jaseg/sampling-mesh-monitor/analysis/jupyter_notebooks/edge_sampling_pulse_scope.pdf

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

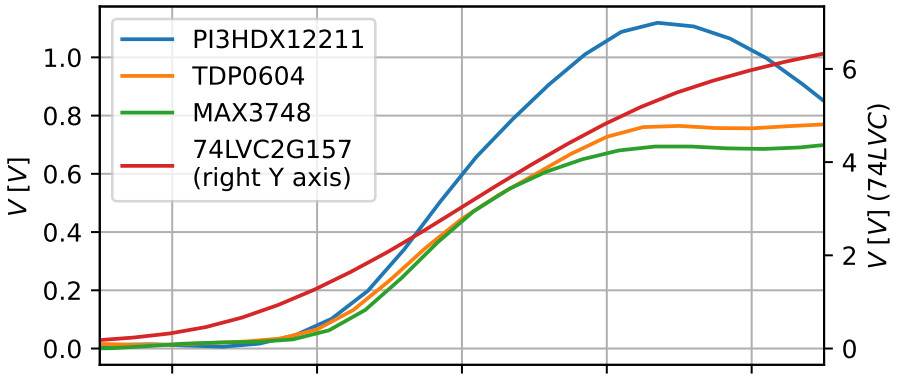
[picture p79: figure]
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
