jaseg/sampling-mesh-monitor/analysis/jupyter_notebooks/edge_stimulus_pulse_scope_normalized.pdf

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

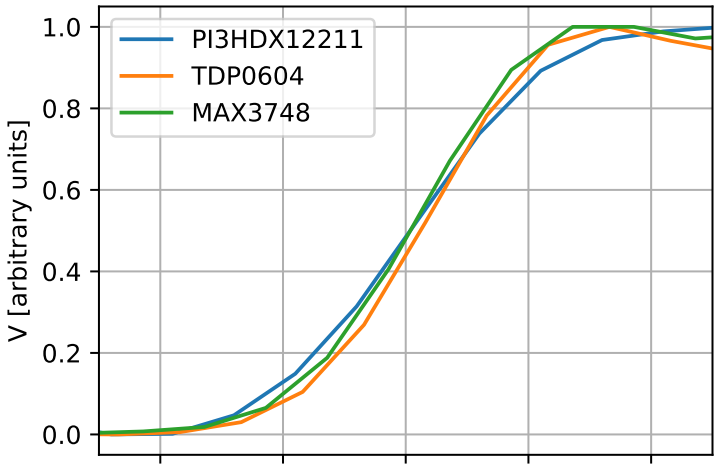
[picture p81: figure]
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
