jaseg/sampling-mesh-monitor/paper/fig_cdf_distinguish_copies_large_run.pdf

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

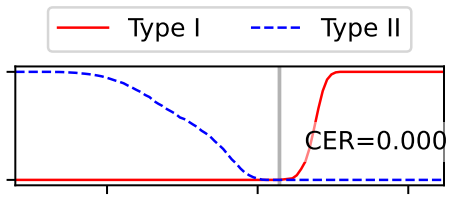
[picture p85: figure]
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
