jaseg/sampling-mesh-monitor/paper/fig_cdf_environment_p1.0_minmax.pdf

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

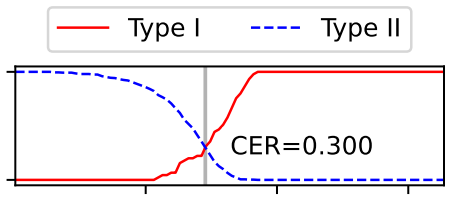
[picture p94: figure]
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
