jaseg/sampling-mesh-monitor/paper/fig_cdf_environment_ref_probe_p0.3_minmax.pdf

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

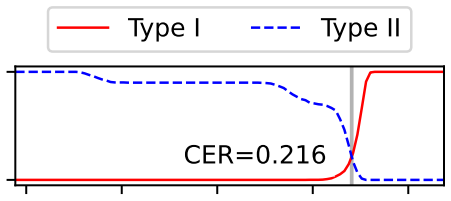
[picture p96: figure]
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
