jaseg/sampling-mesh-monitor/paper/fig_cdf_hot_mesh.pdf

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

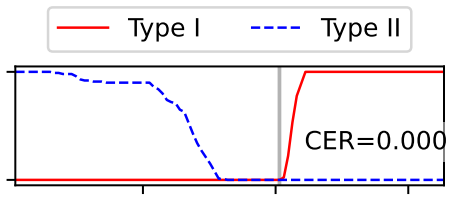
[picture p97: figure]
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
