jaseg/sampling-mesh-monitor/paper/fig_cdf_open_p0.4.pdf

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

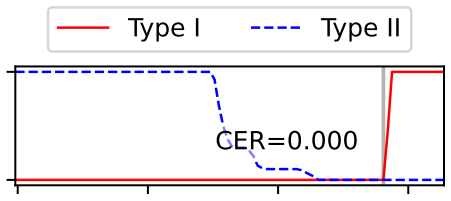
[picture p100: figure]
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
