jaseg/sampling-mesh-monitor/paper/fig_cdf_patch_0.3mm_large_sample_minmax.pdf

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

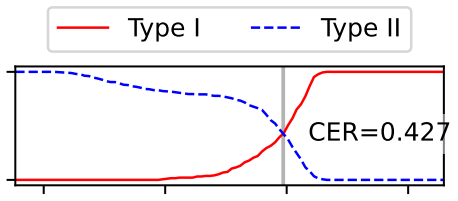
[picture p102: figure]
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
