jaseg/sampling-mesh-monitor/paper/fig_cdf_patch_interleave_classifier.pdf

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

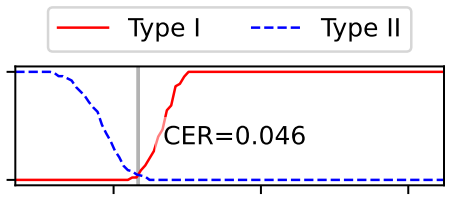
[picture p104: figure]
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
