jaseg/sampling-mesh-monitor/paper/fig_cdf_probe_0.4.pdf

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

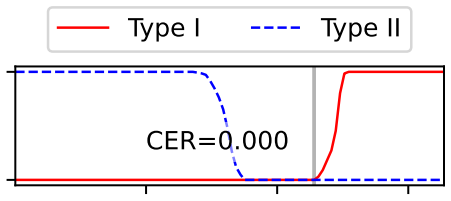
[picture p114: figure]
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
