jaseg/sampling-mesh-monitor/paper/fig_cdf_short_across_traces_p0.4.pdf

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

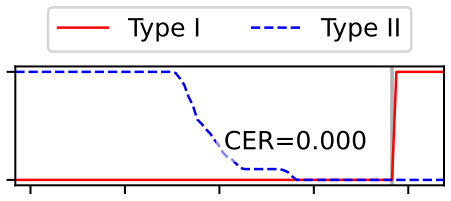
[picture p121: figure]
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
