jaseg/sampling-mesh-monitor/paper/fig_cdf_short_within_0.3_min_max.pdf

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

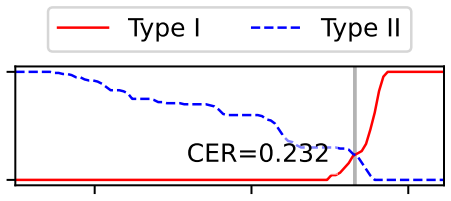
[picture p124: figure]
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
