jaseg/sampling-mesh-monitor/paper/fig_cdf_time_drift.pdf

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

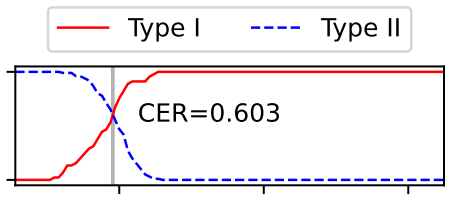
[picture p125: figure]
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
