jaseg/sampling-mesh-monitor/paper/fig_covar_antenna_wire_30mm_p0.3.pdf

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

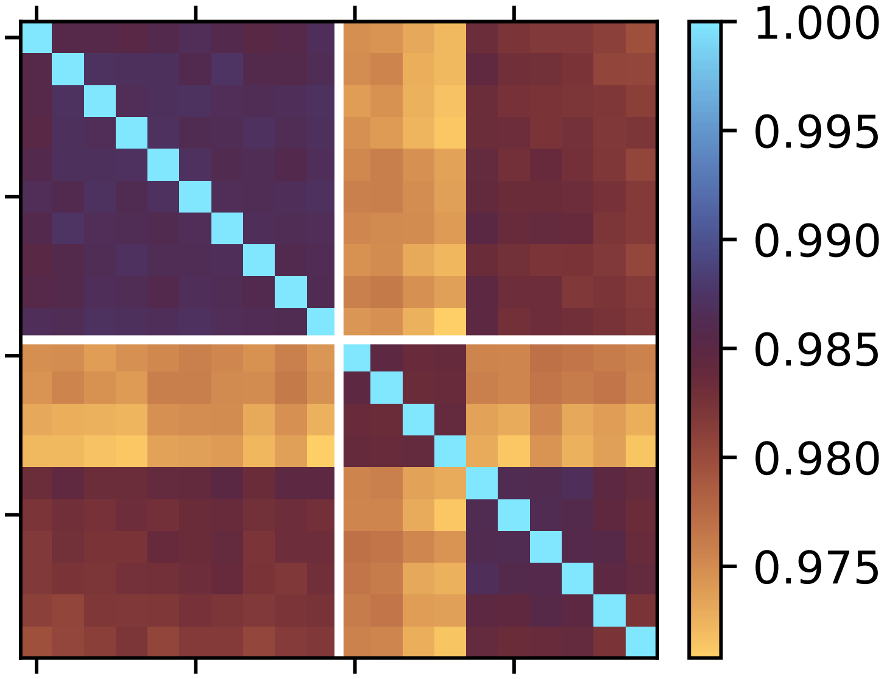
[picture p132: page 1]
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
