jaseg/sampling-mesh-monitor/paper/fig_covar_open_p0.4_minmax.pdf

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

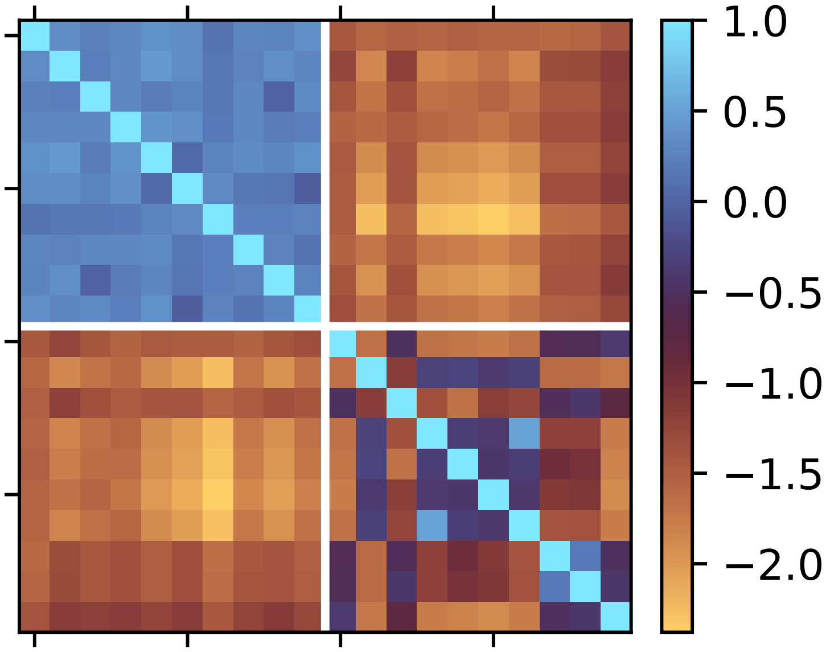
[picture p139: page 1]
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
