jaseg/sampling-mesh-monitor/analysis/data_multi/elevated_temperature_thermal_images/IRAY0331.jpg

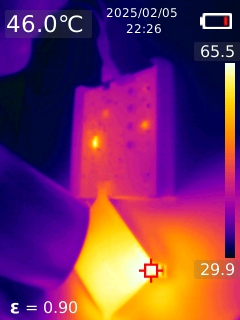
analysis/data_multi/elevated_temperature_thermal_images/IRAY0331.jpg
