jaseg/sampling-mesh-monitor/analysis/data_scope/max_osc.png

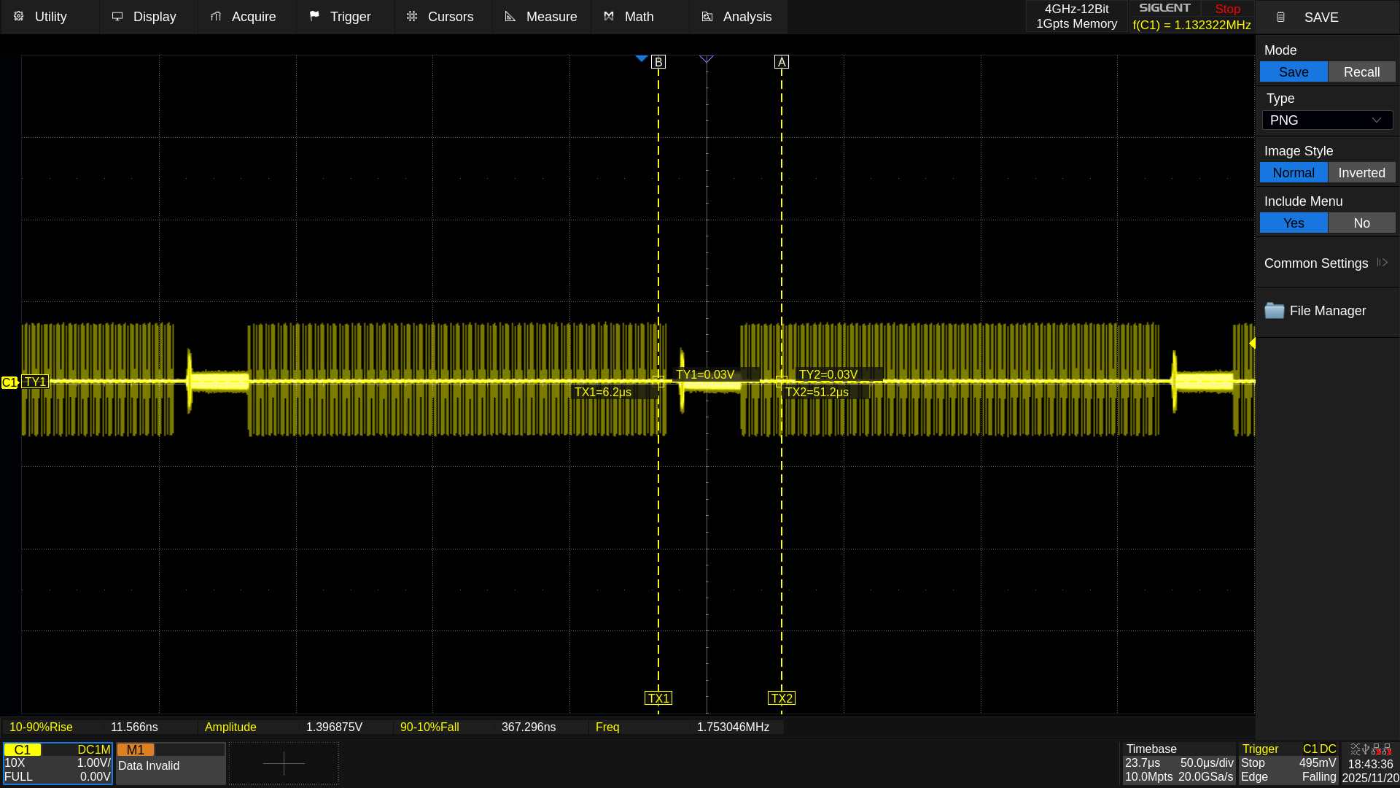
analysis/data_scope/max_osc.png
