jaseg/sampling-mesh-monitor/analysis/data_scope/max_pulse_neg_2.png

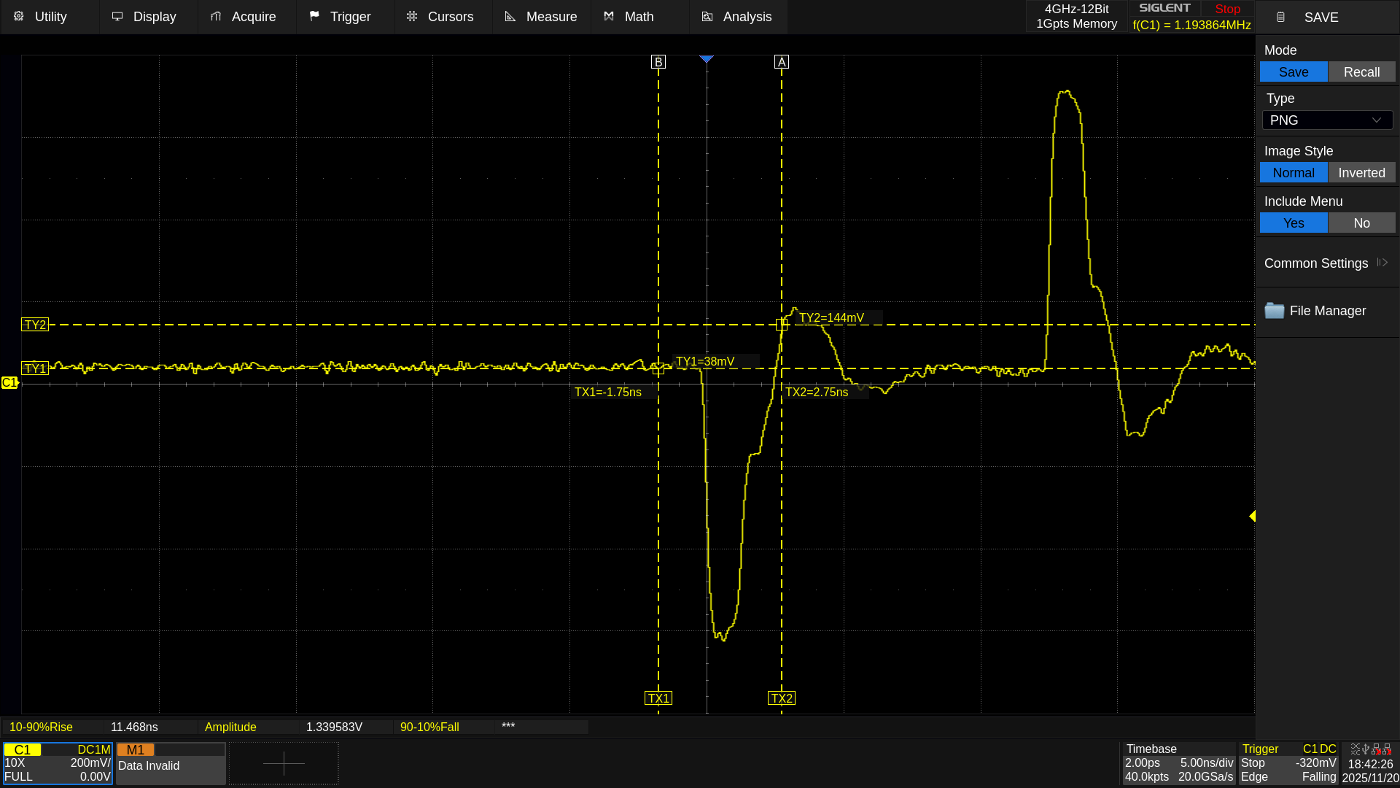
analysis/data_scope/max_pulse_neg_2.png
