jaseg/sampling-mesh-monitor/analysis/data_scope/pi3hdx_fall_74lvc_5.png

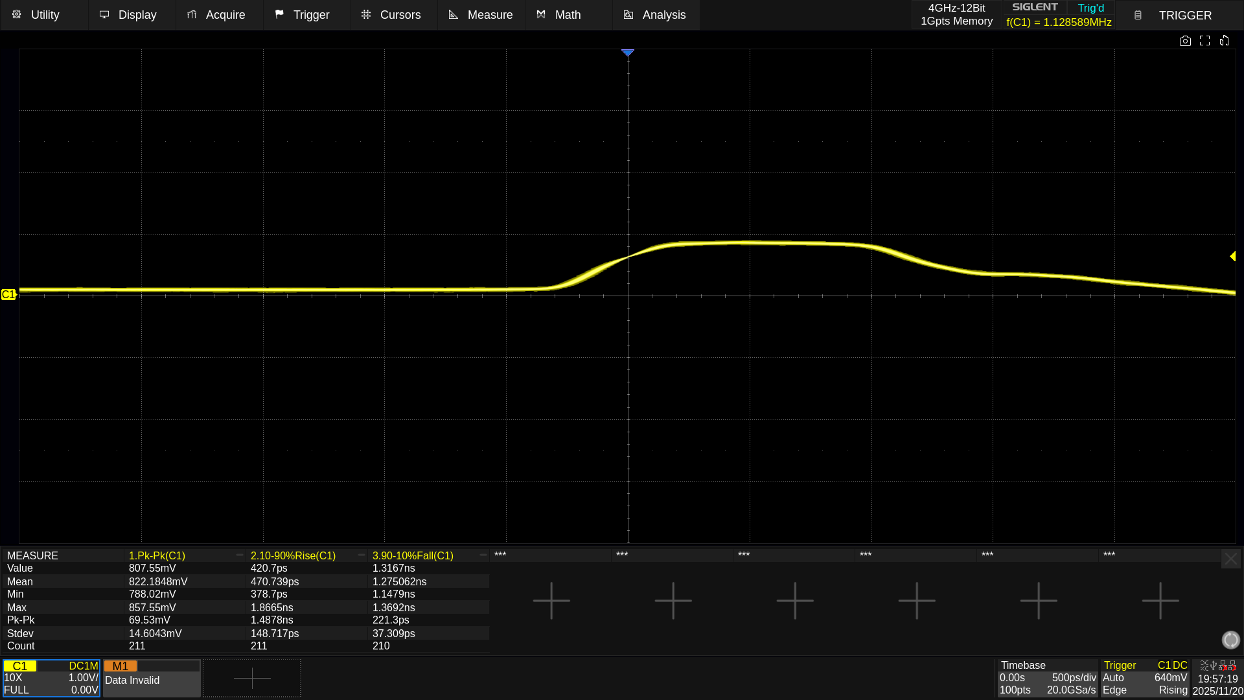
analysis/data_scope/pi3hdx_fall_74lvc_5.png
