jaseg/sampling-mesh-monitor/analysis/data_scope/stimulus_tdp0604_50ohm_13.png

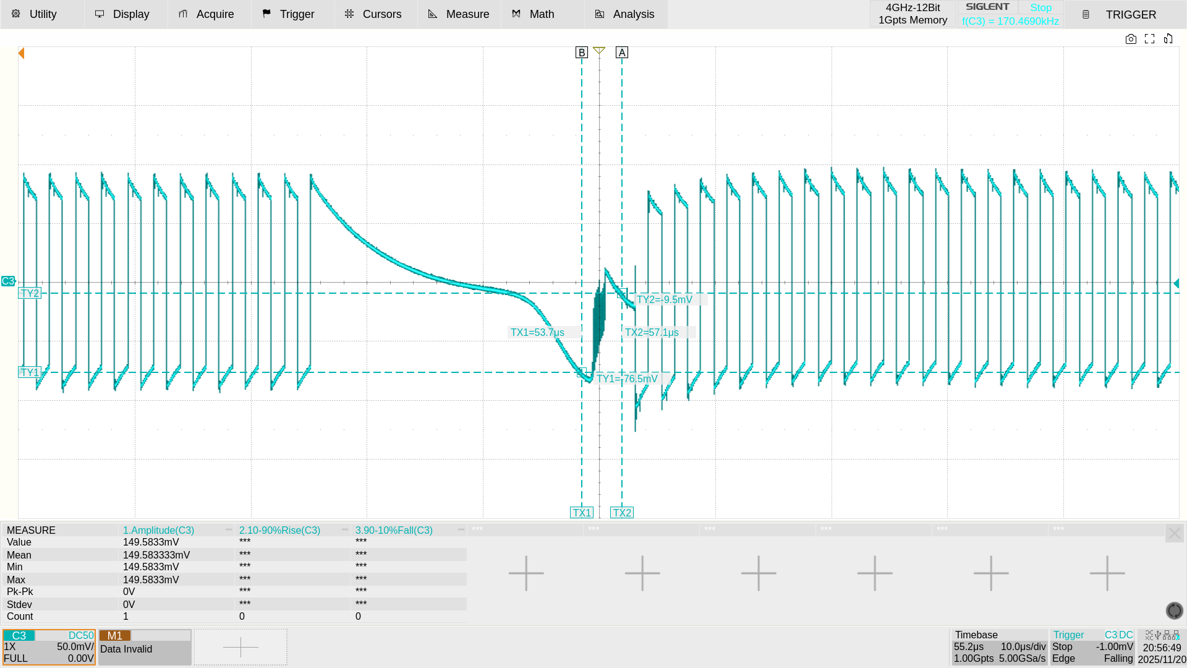
analysis/data_scope/stimulus_tdp0604_50ohm_13.png
