jaseg/sampling-mesh-monitor/analysis/data_scope/stimulus_tdp0604_50ohm_14.png

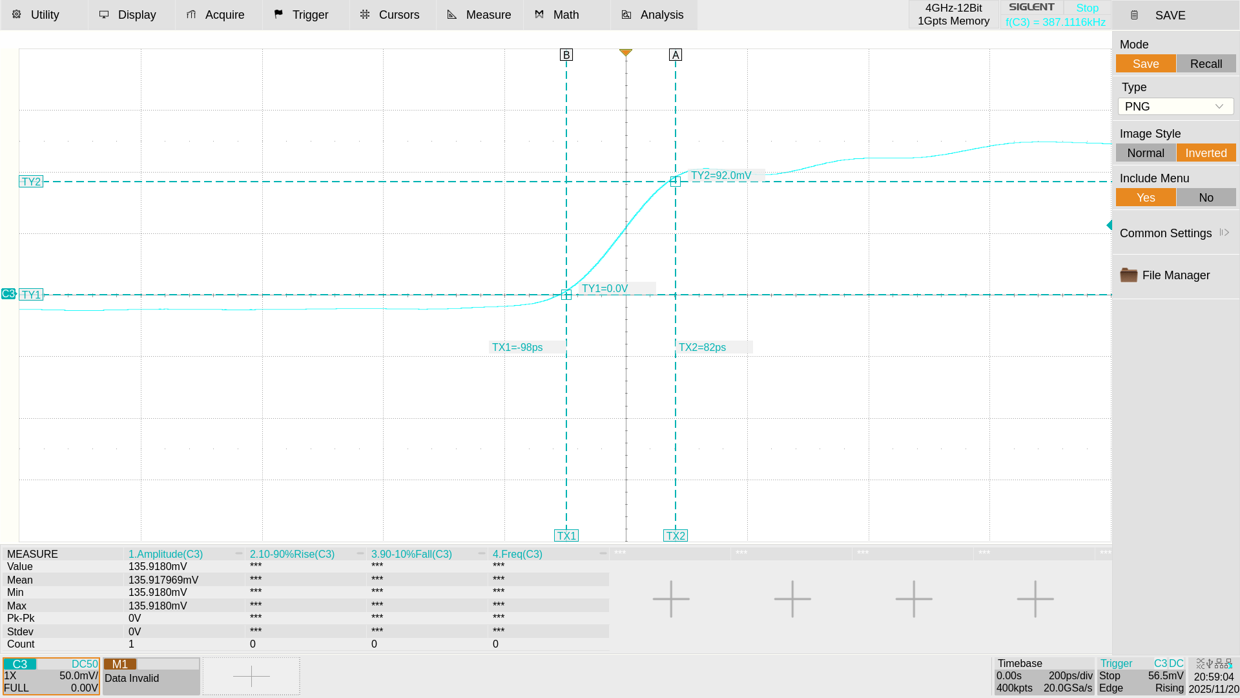
analysis/data_scope/stimulus_tdp0604_50ohm_14.png
