jaseg/sampling-mesh-monitor/analysis/jupyter_notebooks/edge_stimulus_pulse_scope_normalized.png

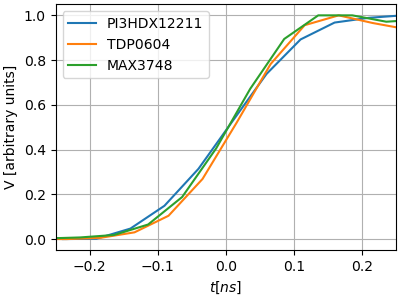
analysis/jupyter_notebooks/edge_stimulus_pulse_scope_normalized.png
