jaseg/sampling-mesh-monitor/paper/pic_cut_1.jpg

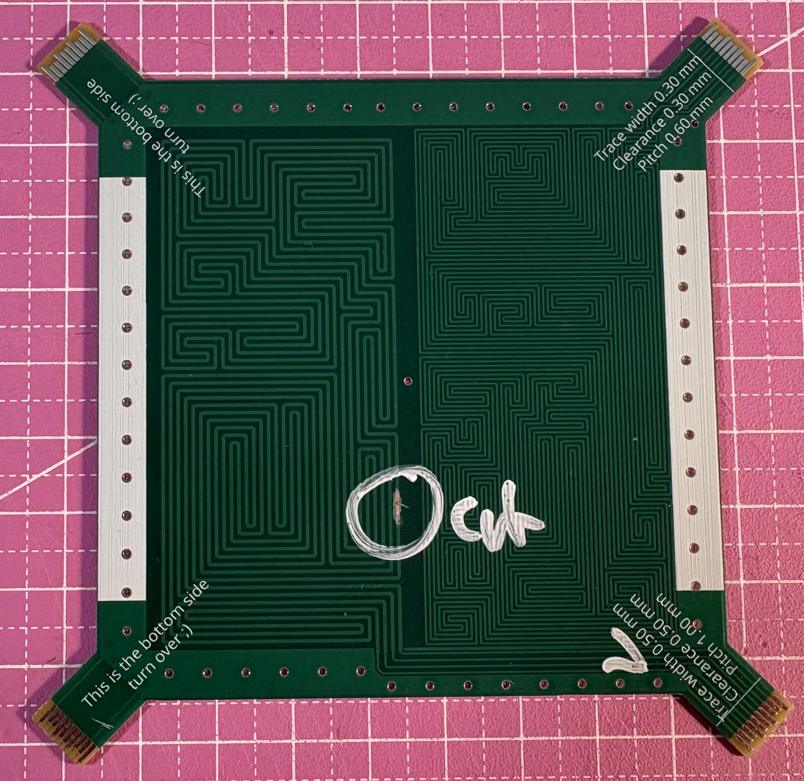
paper/pic_cut_1.jpg
