jaseg/sampling-mesh-monitor/paper/pic_short_1.jpg

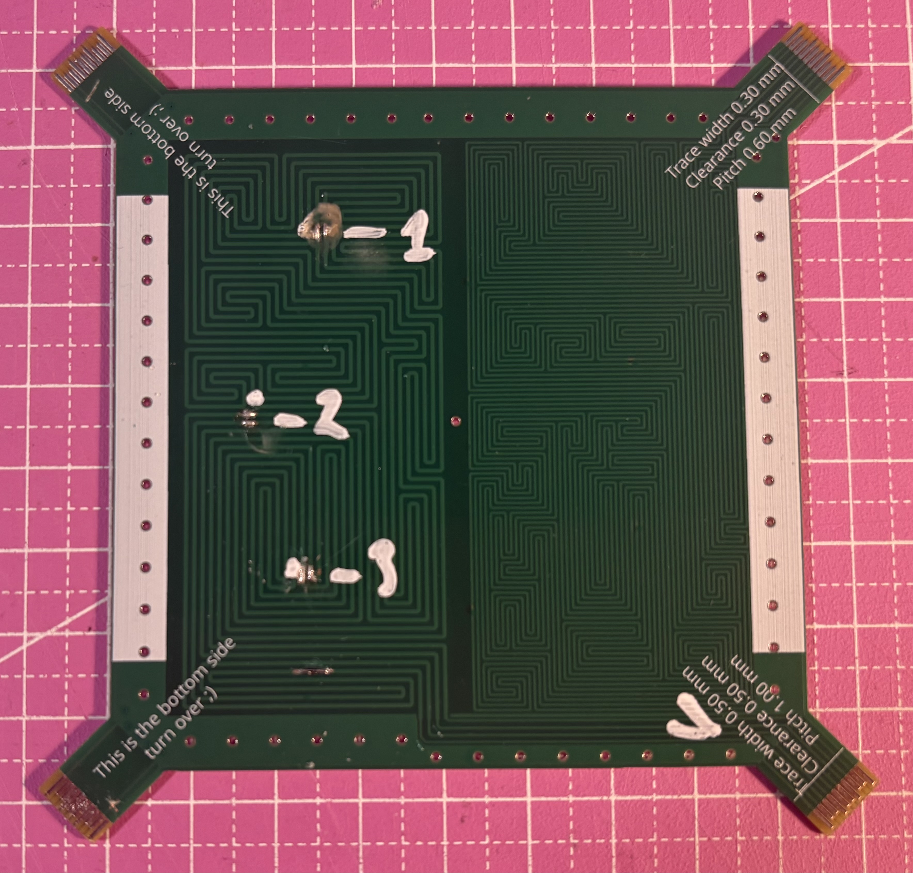
paper/pic_short_1.jpg
