jaseg/sampling-mesh-monitor/paper/pic_short_2.jpg

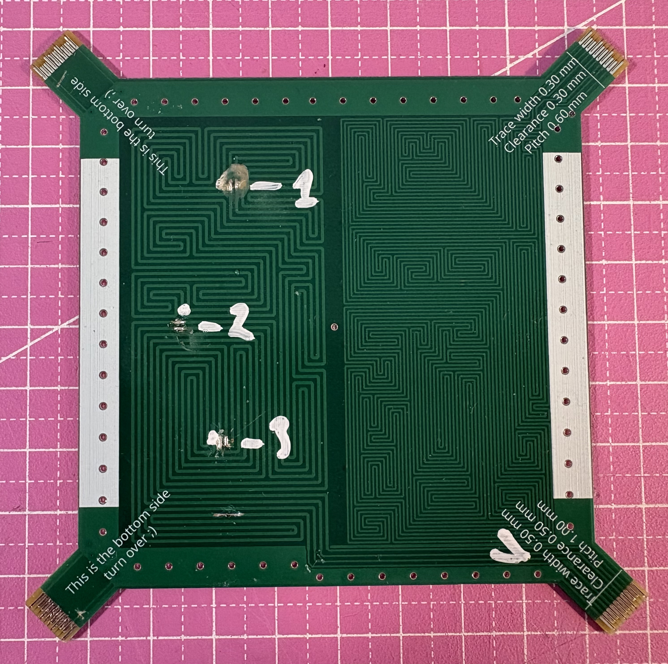
paper/pic_short_2.jpg
