jaseg/sampling-mesh-monitor/main_pcb/fab/bom.csv

Comment | Designator | Footprint | LCSC
22k | R68,R73,R75 | Resistor_SMD:R_0402_1005Metric | C25768
47u | C4,C70,C71,C72,C73 | Capacitor_SMD:C_Elec_6.3x7.7 | C88810
10n | C3,C11,C15,C17,C18,C19,C20,C21,C22,C23,C24,C25,C26,C31,C32,C33,C36,C41,C42,C43,C46,C49,C65,C67,C69,C74,C76,C90 | Capacitor_SMD:C_0402_1005Metric | C15195
1k | R4,R23,R24,R25,R26,R67,R80,R81,R82,R83,R85,R87 | Resistor_SMD:R_0402_1005Metric | C11702
45 | R18,R28,R58,R62 | Resistor_SMD:R_0402_1005Metric | C327342
3k3 | R27,R39,R65,R66 | Resistor_SMD:R_0402_1005Metric | C25890
1u | C2,C6,C7,C10,C12,C14,C27,C38,C39,C44,C48,C52,C56,C57,C58,C63,C75,C77,C78,C79,C80,C81,C84,C86,C88 | Capacitor_SMD:C_0805_2012Metric | C28323
0 | R9,R13,R14,R30,R31,R41,R44,R95,R96 | Resistor_SMD:R_0402_1005Metric | C17168
USBLC6-4SC6 | U10 | Package_TO_SOT_SMD:SOT-23-6 | C558419
AO3400A | Q1 | Package_TO_SOT_SMD:SOT-23 | C20917
10k | R40,R47,R48,R49,R70 | Resistor_SMD:R_0402_1005Metric | C2654005
100n | C1,C5,C8,C9,C13,C16,C28,C34,C35,C37,C40,C45,C47,C53,C54,C55,C59,C60,C62,C64,C66,C68,C82,C83,C85,C87,C89 | Capacitor_SMD:C_0402_1005Metric | C307331
75 | R8,R11,R12,R20,R32,R43 | Resistor_SMD:R_0402_1005Metric | C25133
BLM15HD102SN1D | FB1,FB2,FB3,FB4 | Inductor_SMD:L_0402_1005Metric | C21516
91 | R56,R57,R59,R61 | Resistor_SMD:R_0402_1005Metric | C4071412
1N4148W | D3,D5 | Diode_SMD:D_SOD-123 | C81598
47k | R71,R72,R77,R86 | Resistor_SMD:R_0402_1005Metric | C25792
PTN36241B | U4 | Package_DFN_QFN:QFN-24-1EP_4x4mm_P0.5mm_EP2.6x2.6mm | C2675242
0603 white | D1,D2,D4,D6,D7,D12,D13,D14,D15,D16,D17 | LED_SMD:LED_0603_1608Metric | C2290
SKYA21003 | U5,U6 | footprints:QFN-12_EP_2x2_Pitch0.5mm | C141440
74LVC2G157 | U2,U3 | Package_SO:MSOP-8_3x3mm_P0.65mm | C78048
30 | R42,R45,R51,R52,R53,R54 | Resistor_SMD:R_0402_1005Metric | C138007
100 | R84 | Resistor_SMD:R_0402_1005Metric | C25076
20p | C29,C30 | Capacitor_SMD:C_0402_1005Metric | C1554
OPA1656 | U11,U12,U13 | Package_SO:SO-8_3.9x4.9mm_P1.27mm | C1849431
BAT17-04W | D8,D9,D10,D11 | Package_TO_SOT_SMD:SOT-323_SC-70 | C503474
AMS1117-3.3 | U15,U16,U17 | Package_TO_SOT_SMD:SOT-223-3_TabPin2 | C6186
5k1 | R46,R63 | Resistor_SMD:R_0402_1005Metric | C25905
47 | R64,R78 | Resistor_SMD:R_0603_1608Metric | C23182
TMUXHS4212 | U7,U8 | Package_DFN_QFN:DHVQFN-20-1EP_2.5x4.5mm_P0.5mm_EP1x3mm | C3656912
1M | R74,R76,R79 | Resistor_SMD:R_0402_1005Metric | C138033
USB_C_Receptacle_USB2.0 | J2 | Connector_USB:USB_C_Receptacle_HCTL_HC-TYPE-C-16P-01A | C2988369
8MHz/20p | Y1 | Crystal:Crystal_SMD_5032-2Pin_5.0x3.2mm | C115962
SFP+ | J1 | footprints:HCTL_HC-SFP-20P_C2897291 | C2897291
100k | R69 | Resistor_SMD:R_0402_1005Metric | C25741
STM32G474RBTx | U9 | Package_QFP:LQFP-64_10x10mm_P0.5mm | C529413
TPS7B4253QPWPRQ1 | U1 | Package_SO:HTSSOP-20-1EP_4.4x6.5mm_P0.65mm_EP3.4x6.5mm_Mask2.4x3.7mm | C2879376
LP2998 | U14 | footprints:SOIC-8-1EP_3.9x4.9mm_P1.27mm_EP2.34x2.34mm | C181400
