jaseg/sampling-mesh-monitor/paper/fig_cdf_soldering_p0.3_minmax.pdf

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

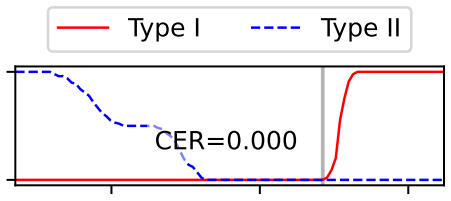
[picture p161: figure]
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
