jaseg/sampling-mesh-monitor/analysis/data_multi/forest_setup.jpg

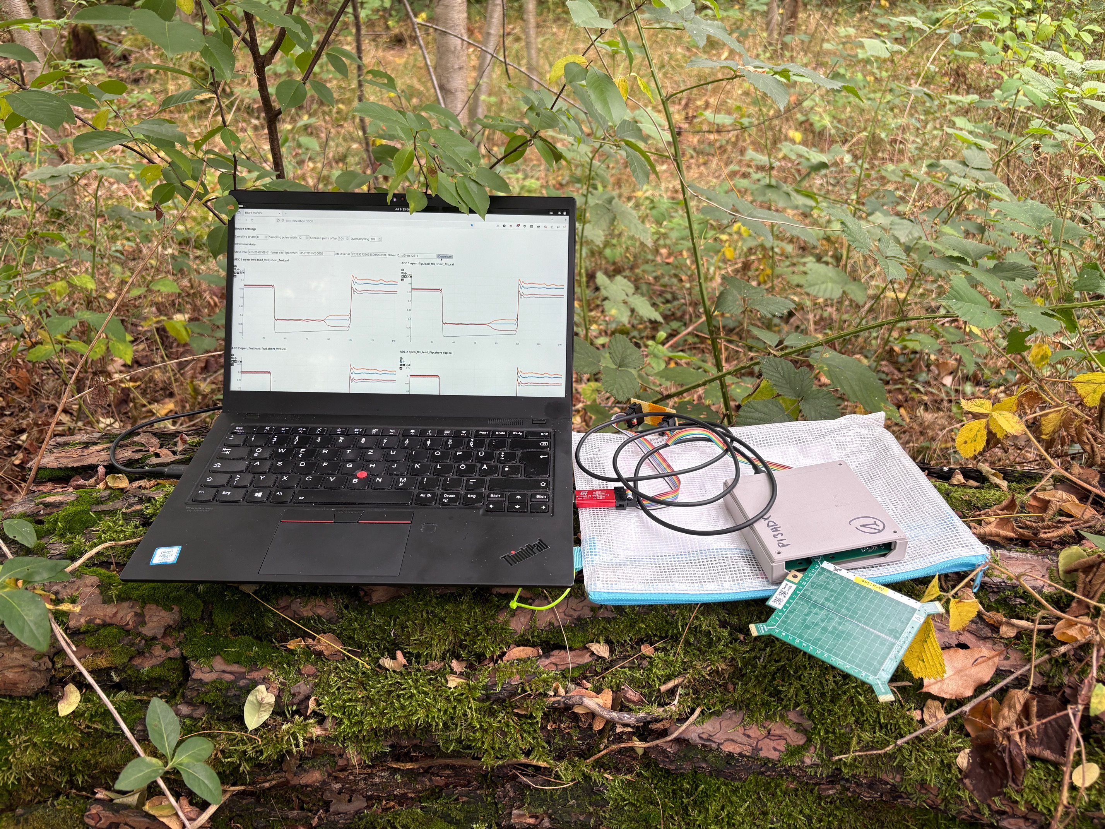
analysis/data_multi/forest_setup.jpg
