jaseg/sampling-mesh-monitor/paper/pic_board_setup.jpg

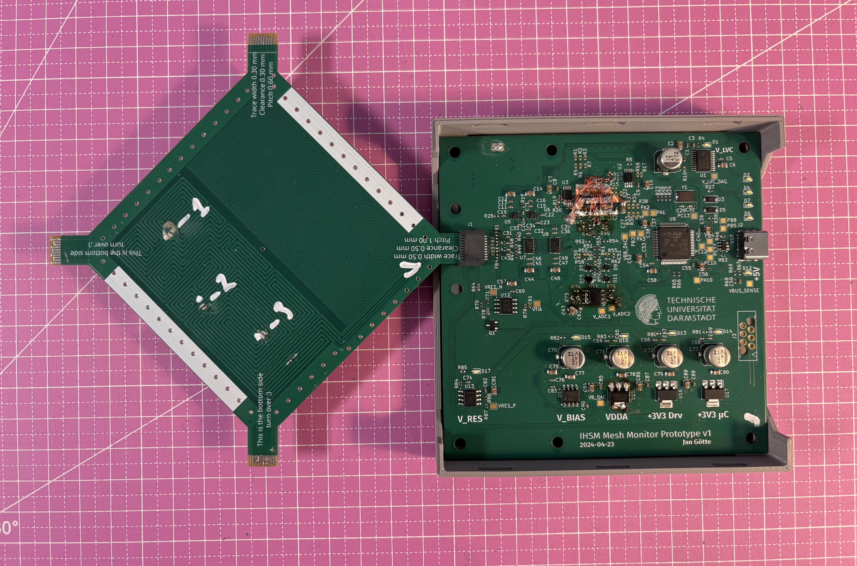
paper/pic_board_setup.jpg
