jaseg/sampling-mesh-monitor/paper/pic_board_setup_2_small_censored.jpg

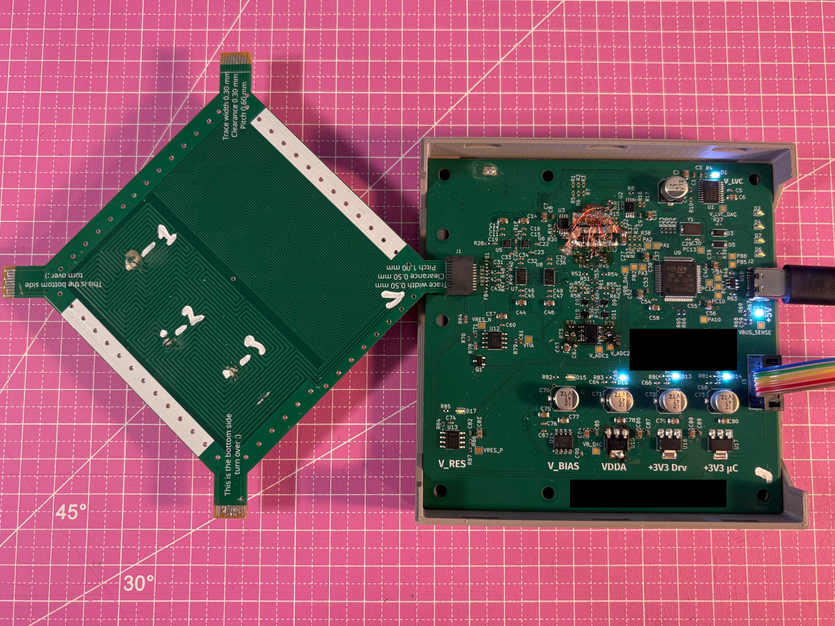
paper/pic_board_setup_2_small_censored.jpg
