jaseg/sampling-mesh-monitor/paper/pic_manip_microsoldering.jpg

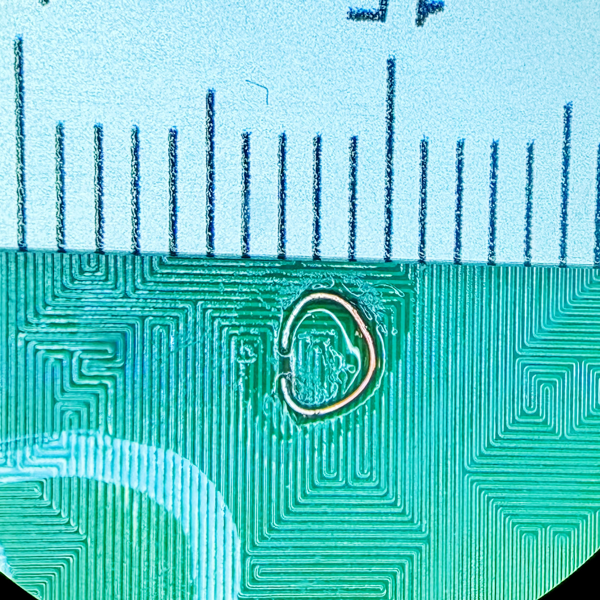
paper/pic_manip_microsoldering.jpg
