jaseg/sampling-mesh-monitor/paper/pic_manip_microsoldering_new.jpg

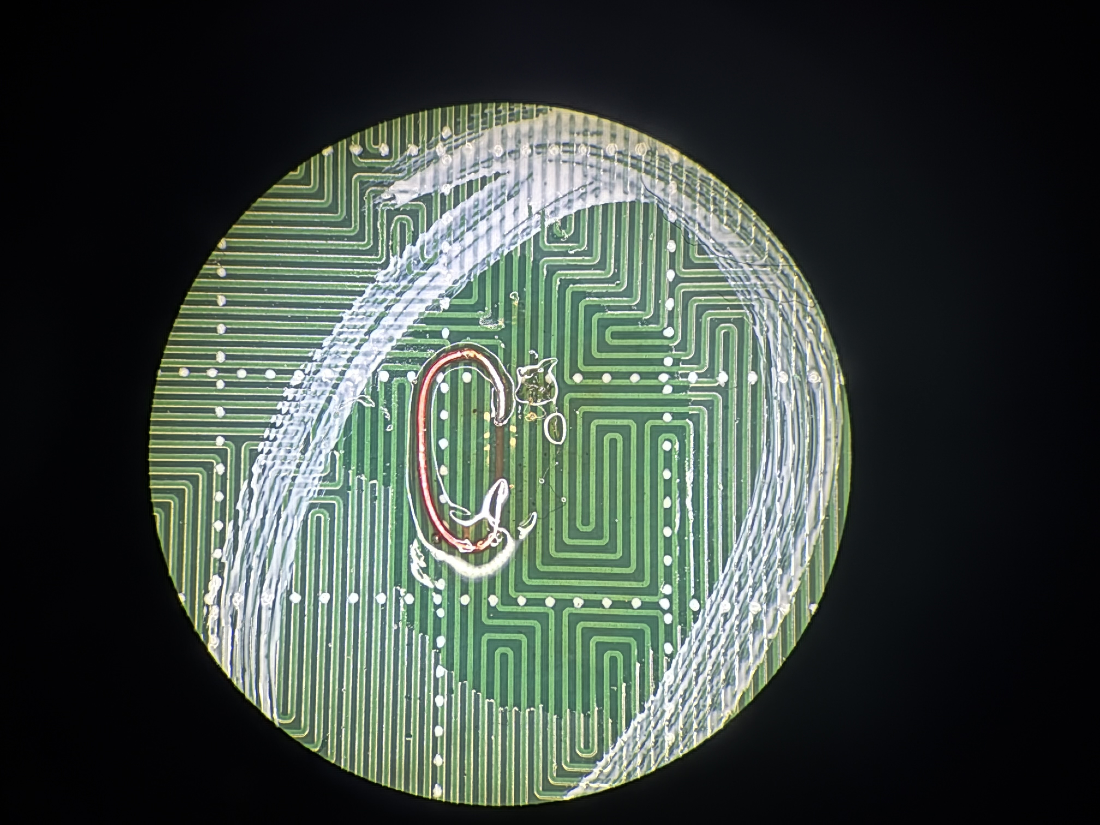
paper/pic_manip_microsoldering_new.jpg
