jaseg/sampling-mesh-monitor/analysis/spectrum_measurements/amp_out_span_2g.csv

Trace
Swept SA
A.14.16 | N9020A
526 | 01
Segment | 0
Number of Points | 1001
Sweep Time | 0.291066666667
Start Frequency | 1000000
Stop Frequency | 2000000000
Average Count | 0
Average Type | LogPower(Video)
RBW | 91000
RBW Filter | Gaussian
RBW Filter BW | 3dB
VBW | 91000
Sweep Type | Swept
X Axis Scale | Lin
PreAmp State | Off
PreAmp Band | Low
Trigger Source | Free
Trigger Level | 1.2
Trigger Slope | Positive
Trigger Delay | 0
Phase Noise Optimization | Fast
Swept If Gain | Low
FFT If Gain | Autorange
RF Coupling | AC
FFT Width | 411900
Ext Ref | 10000000
Input | RF
RF Calibrator | Off
Attenuation | 10
Ref Level Offset | 0
External Gain | 0
Trace Type | Clearwrite
Detector | Normal
Trace Math | Off
Trace Math Oper1 | Trace5
Trace Math Oper2 | Trace6
Trace Math Offset | 0
Normalize | Off
Trace Name | Trace1
X Axis Units | Hz
Y Axis Units | dBm
DATA
1000000 | -2.92567873001099
2999000 | -105.294227600098
4998000 | -81.9323806762695
6997000 | -106.628311157227
8996000 | -27.1905555725098
10995000 | -110.134819030762
12994000 | -83.3165969848633
14993000 | -106.727844238281
16992000 | -78.3774490356445
18991000 | -113.527038574219
20990000 | -86.3876037597656
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
