jaseg/sampling-mesh-monitor/analysis/spectrum_measurements/amp_out_span_2g_rbw_10k_40kpt_0000.csv

Trace
Swept SA
A.14.16 | N9020A
526 | 01
Segment | 0
Number of Points | 40001
Sweep Time | 24.104
Start Frequency | 1000000
Stop Frequency | 2000000000
Average Count | 0
Average Type | LogPower(Video)
RBW | 10000
RBW Filter | Gaussian
RBW Filter BW | 3dB
VBW | 10000
Sweep Type | Swept
X Axis Scale | Lin
PreAmp State | Off
PreAmp Band | Low
Trigger Source | Free
Trigger Level | 1.2
Trigger Slope | Positive
Trigger Delay | 0
Phase Noise Optimization | Fast
Swept If Gain | Low
FFT If Gain | Autorange
RF Coupling | AC
FFT Width | 411900
Ext Ref | 10000000
Input | RF
RF Calibrator | Off
Attenuation | 10
Ref Level Offset | 0
External Gain | 0
Trace Type | Clearwrite
Detector | Normal
Trace Math | Off
Trace Math Oper1 | Trace5
Trace Math Oper2 | Trace6
Trace Math Offset | 0
Normalize | Off
Trace Name | Trace1
X Axis Units | Hz
Y Axis Units | dBm
DATA
1000000 | -85.3238830566406
1049975 | -98.9215316772461
1099950 | -86.7866973876953
1149925 | -108.657447814941
1199900 | -88.6867828369141
1249875 | -114.095260620117
1299850 | -87.331413269043
1349825 | -106.659980773926
1399800 | -86.4431533813477
1449775 | -105.568656921387
1499750 | -87.967155456543
1549725 | -113.770057678223
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
