jaseg/sampling-mesh-monitor/analysis/spectrum_measurements/board_out_span_2g_rbw_10k_40kpt.csv

Trace
Swept SA
A.14.16 | N9020A
526 | 01
Segment | 0
Number of Points | 40001
Sweep Time | 24.104
Start Frequency | 1000000
Stop Frequency | 2000000000
Average Count | 0
Average Type | LogPower(Video)
RBW | 10000
RBW Filter | Gaussian
RBW Filter BW | 3dB
VBW | 10000
Sweep Type | Swept
X Axis Scale | Lin
PreAmp State | Off
PreAmp Band | Low
Trigger Source | Free
Trigger Level | 1.2
Trigger Slope | Positive
Trigger Delay | 0
Phase Noise Optimization | Fast
Swept If Gain | Low
FFT If Gain | Autorange
RF Coupling | AC
FFT Width | 411900
Ext Ref | 10000000
Input | RF
RF Calibrator | Off
Attenuation | 10
Ref Level Offset | 0
External Gain | 0
Trace Type | Clearwrite
Detector | Normal
Trace Math | Off
Trace Math Oper1 | Trace5
Trace Math Oper2 | Trace6
Trace Math Offset | 0
Normalize | Off
Trace Name | Trace1
X Axis Units | Hz
Y Axis Units | dBm
DATA
1000000 | -82.1544494628906
1049975 | -107.743324279785
1099950 | -84.4499359130859
1149925 | -106.985504150391
1199900 | -87.2609634399414
1249875 | -104.96794128418
1299850 | -88.4271774291992
1349825 | -105.71981048584
1399800 | -87.4483947753906
1449775 | -108.276962280273
1499750 | -90.7405319213867
1549725 | -104.996360778809
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
