jaseg/sampling-mesh-monitor/analysis/spectrum_measurements/amp_out_span_2g_rbw_10k_40kpt.png

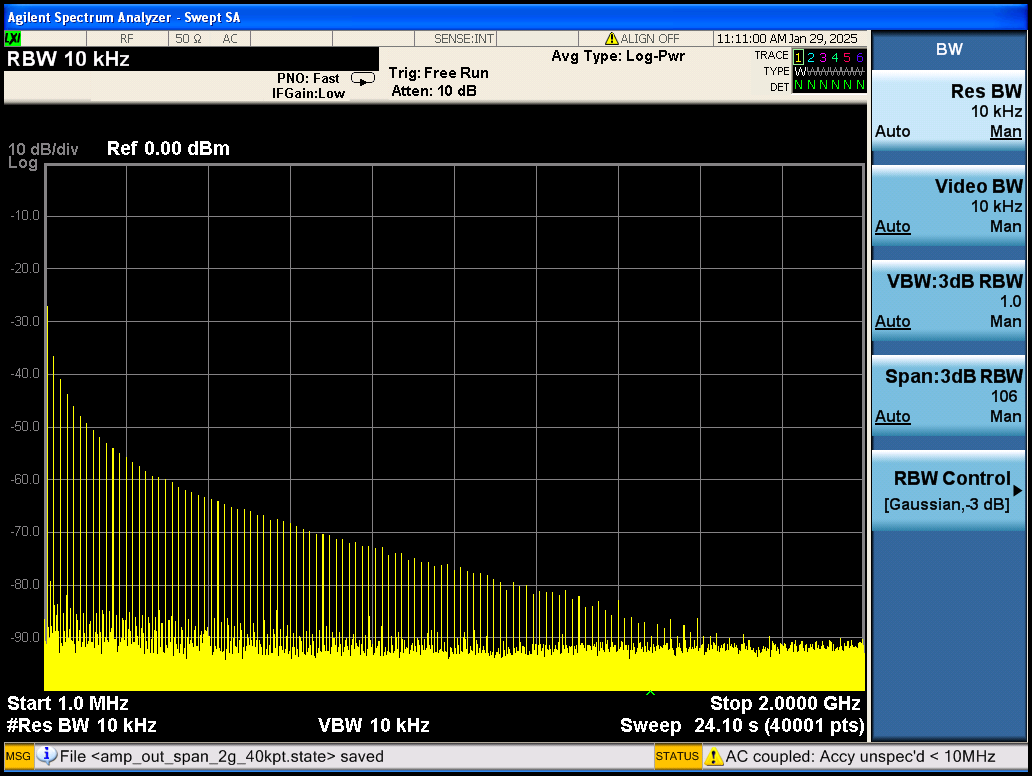
analysis/spectrum_measurements/amp_out_span_2g_rbw_10k_40kpt.png
