jaseg/sampling-mesh-monitor/main_pcb/schematics/sampling-mesh-monitor.pdf

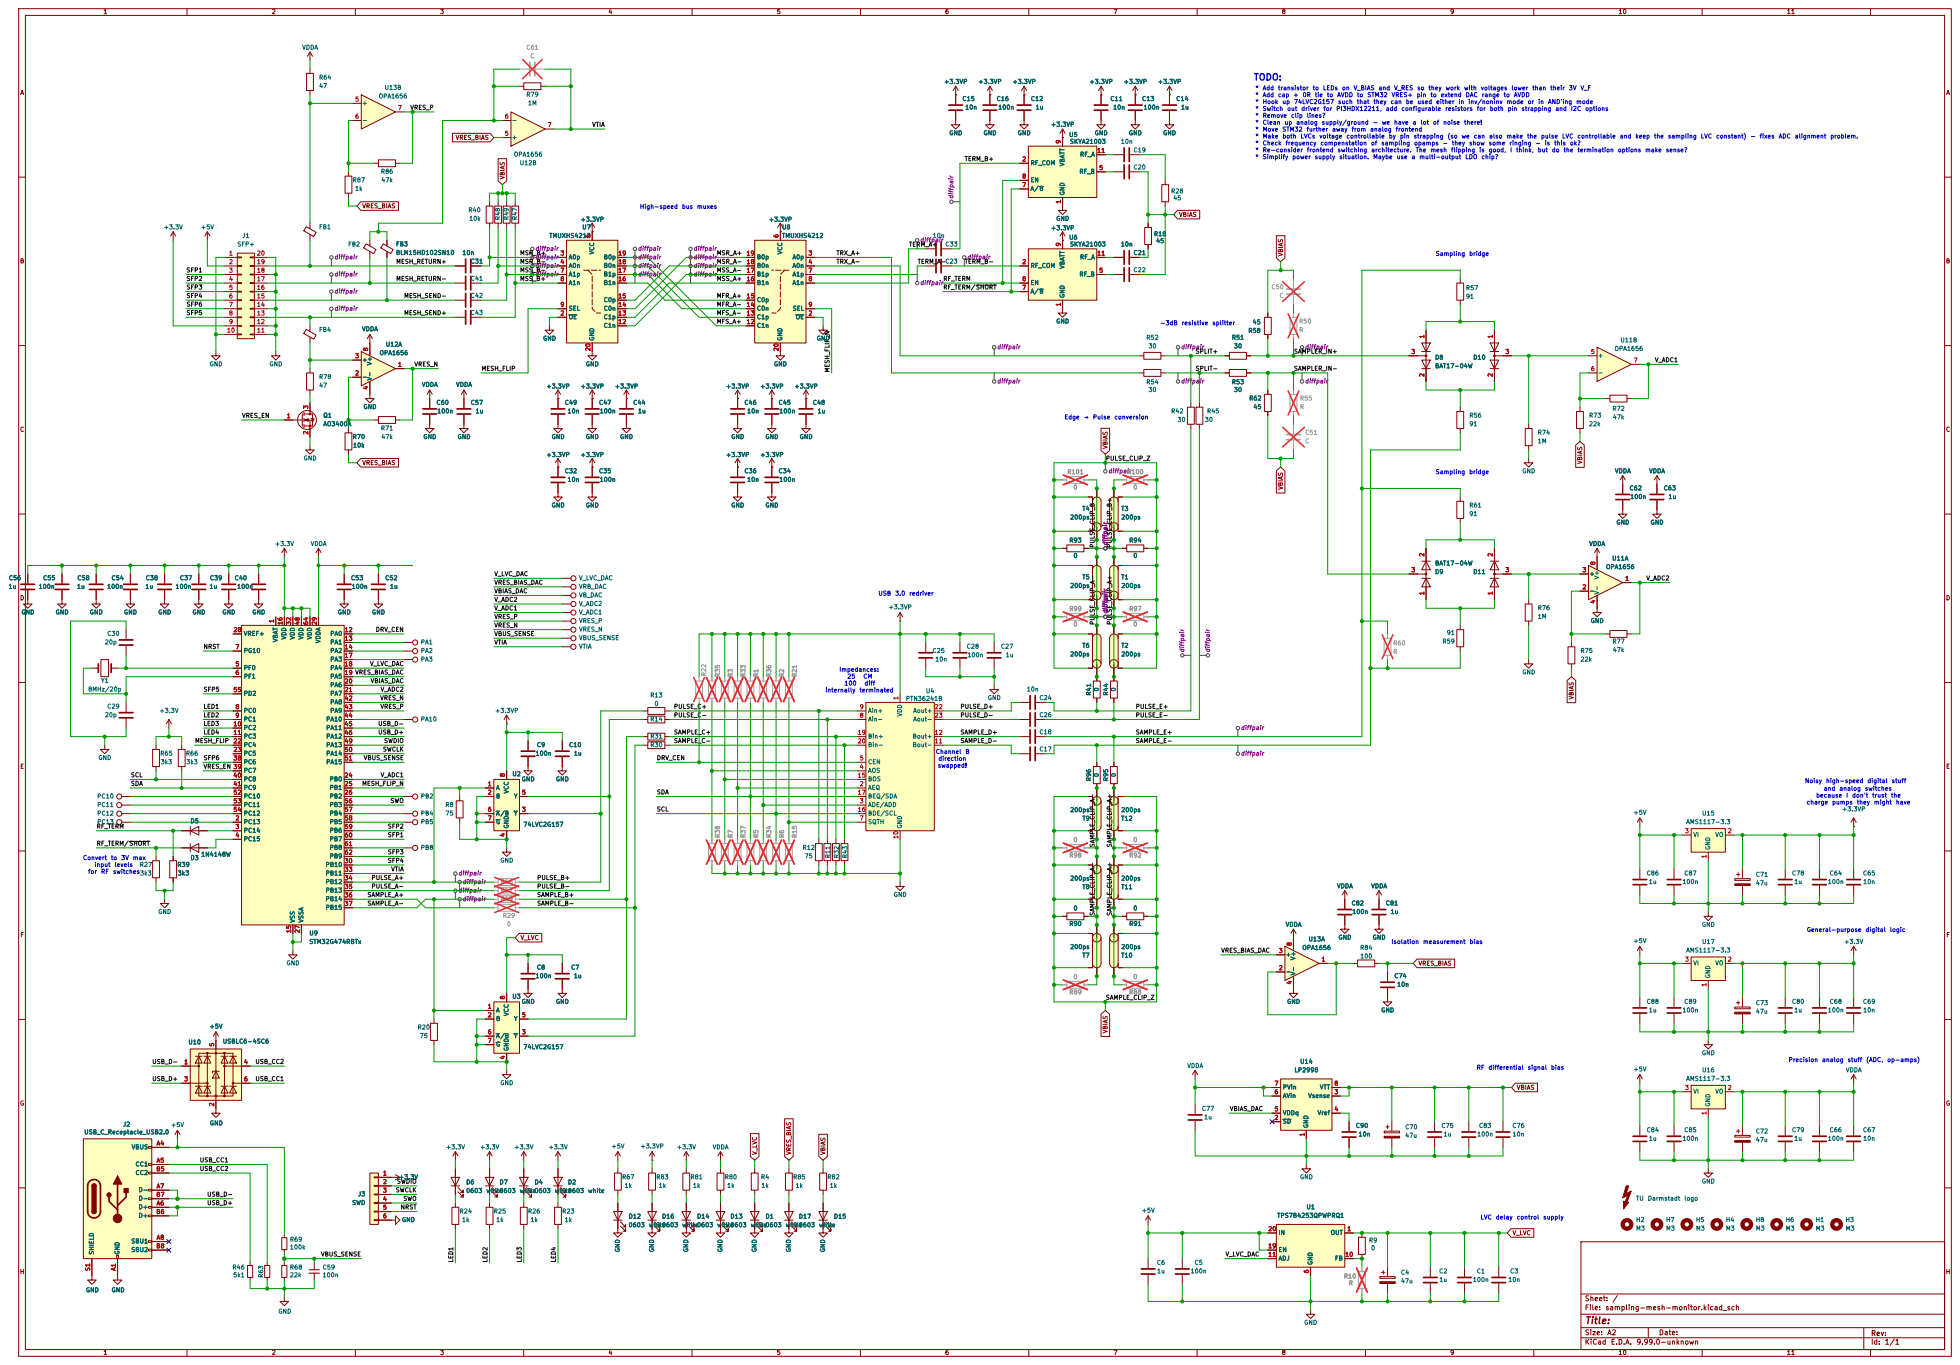
[picture p168: page 1]

* Add transistor to LEDs on V_BIAS and V_RES so they work with voltages lower than their 3V V_F
* Add cap + 0R tie to AVDD to STM32 VRES+ pin to extend DAC range to AVDD
* Hook up 74LVC2G157 such that they can be used either in inv/noninv mode or in AND'ing mode
* Switch out driver for PI3HDX12211, add configurable resistors for both pin strapping and I2C options
* Remove clip lines?
* Clean up analog supply/ground - we have a lot of noise there! * Move STM32 further away from analog frontend

* Make both LVCs voltage controllable by pin strapping (so we can also make the pulse LVC controllable and keep the sampling LVC constant) - fixes ADC alignment problem.
* Check frequency compenstation of sampling opamps - they show some ringing - is this ok?
* Re-consider frontend switching architecture. The mesh flipping is good, I think, but do the termination options make sense?
* Simplify power supply situation. Maybe use a multi-output LDO chip?

High-speed bus muxes

9 | 12
10 | 11

Edge → Pulse conversion Channel B

SQTH 7 BDE/SCL 16 ADE/ADD 3 BEQ/SDA 17 AEQ 2 BOS 15 AOS 4 CEN 5 Bin- 20 Bin+ 19

Noisy high-speed digital stuff Precision analog stuff (ADC, op-amps)

and analog switches because I don't trust the

charge pumps they might have

General-purpose digital logic

Isolation measurement biasRF differential signal bias

LVC delay control supply

Sheet: /
File: sampling-mesh-monitor.kicad_sch
Title:
