jaseg/sampling-mesh-monitor/main_pcb/sampling-mesh-monitor-schematic-anonymized.pdf

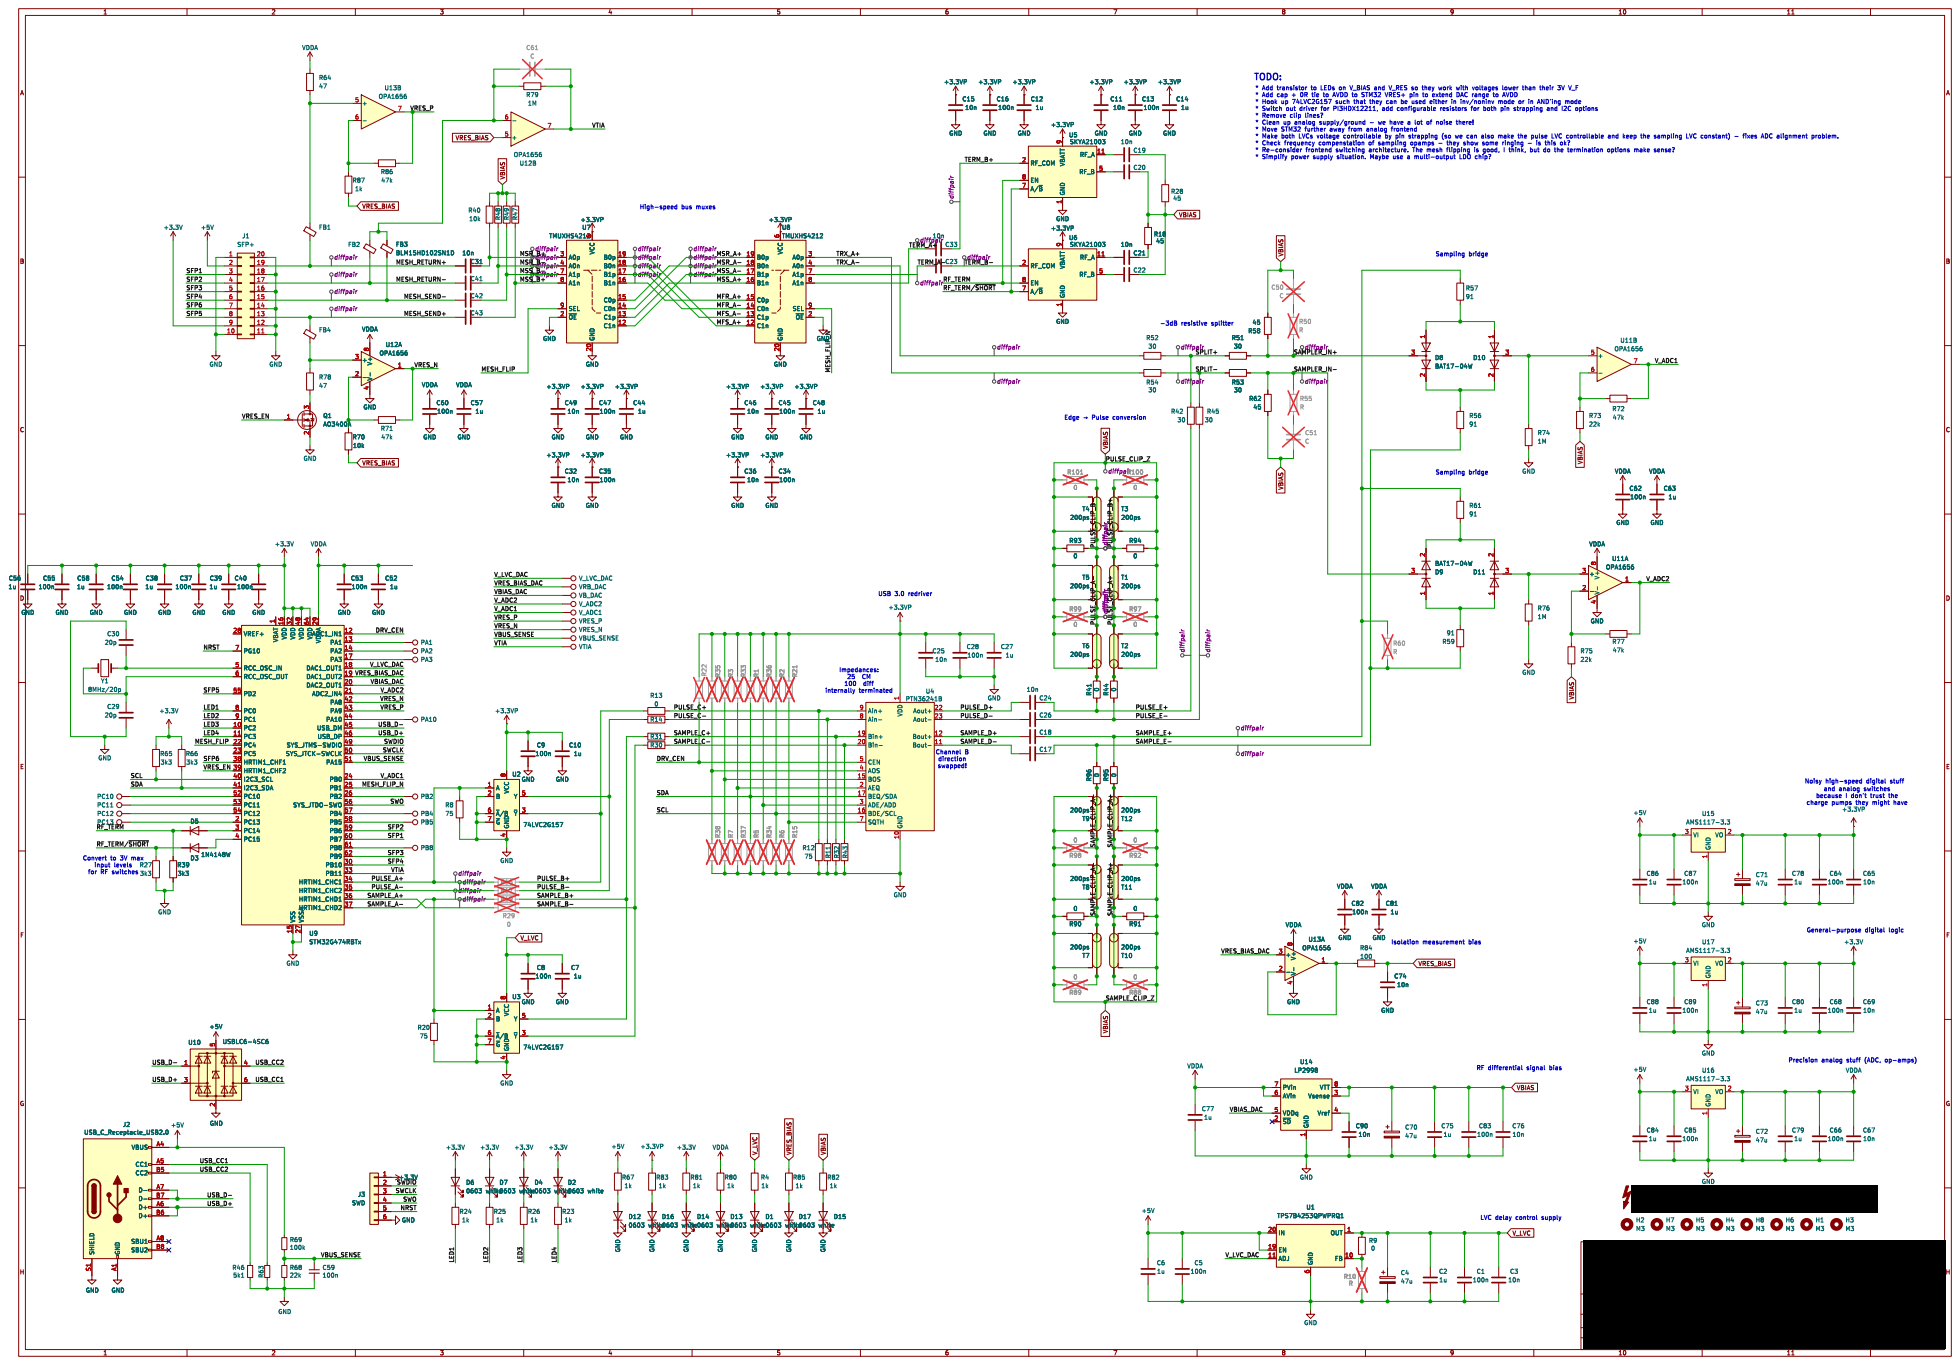
[picture p169: page 1]
