jaseg/sampling-mesh-monitor/paper/fig_short_interleave_scatter.pdf

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

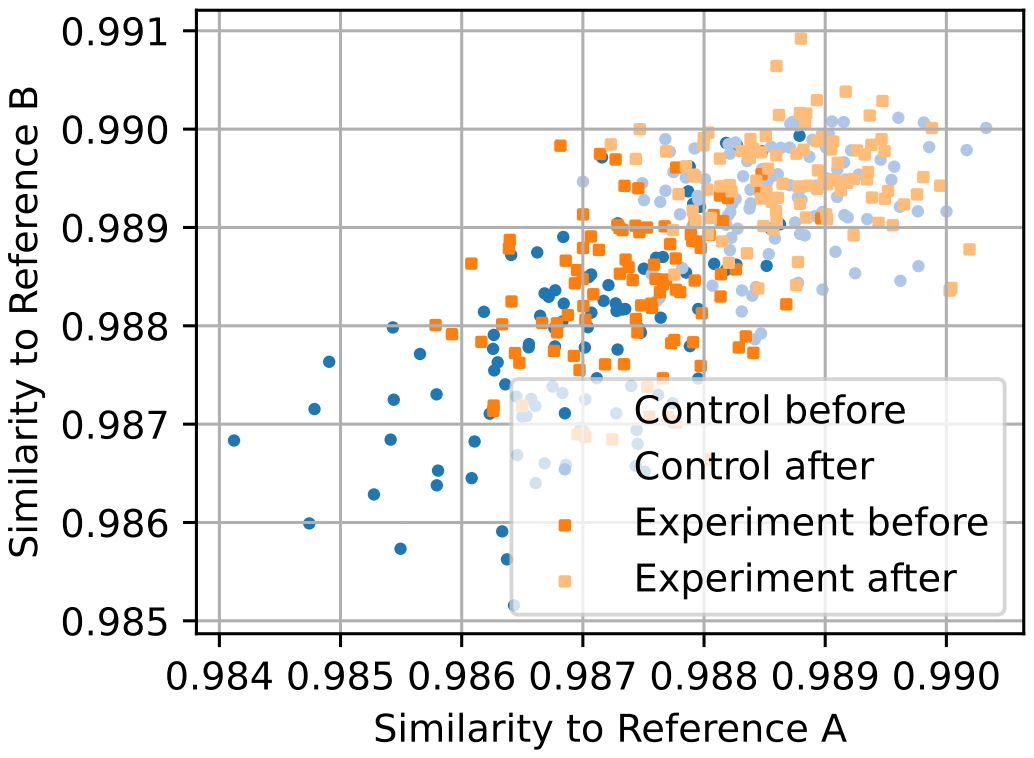
[picture p173: page 1]
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
