jaseg/sampling-mesh-monitor/main_pcb/sampling-mesh-monitor.kicad_pcb

## KiCad design main_pcb/sampling-mesh-monitor.kicad_pcb (2024-11-23)

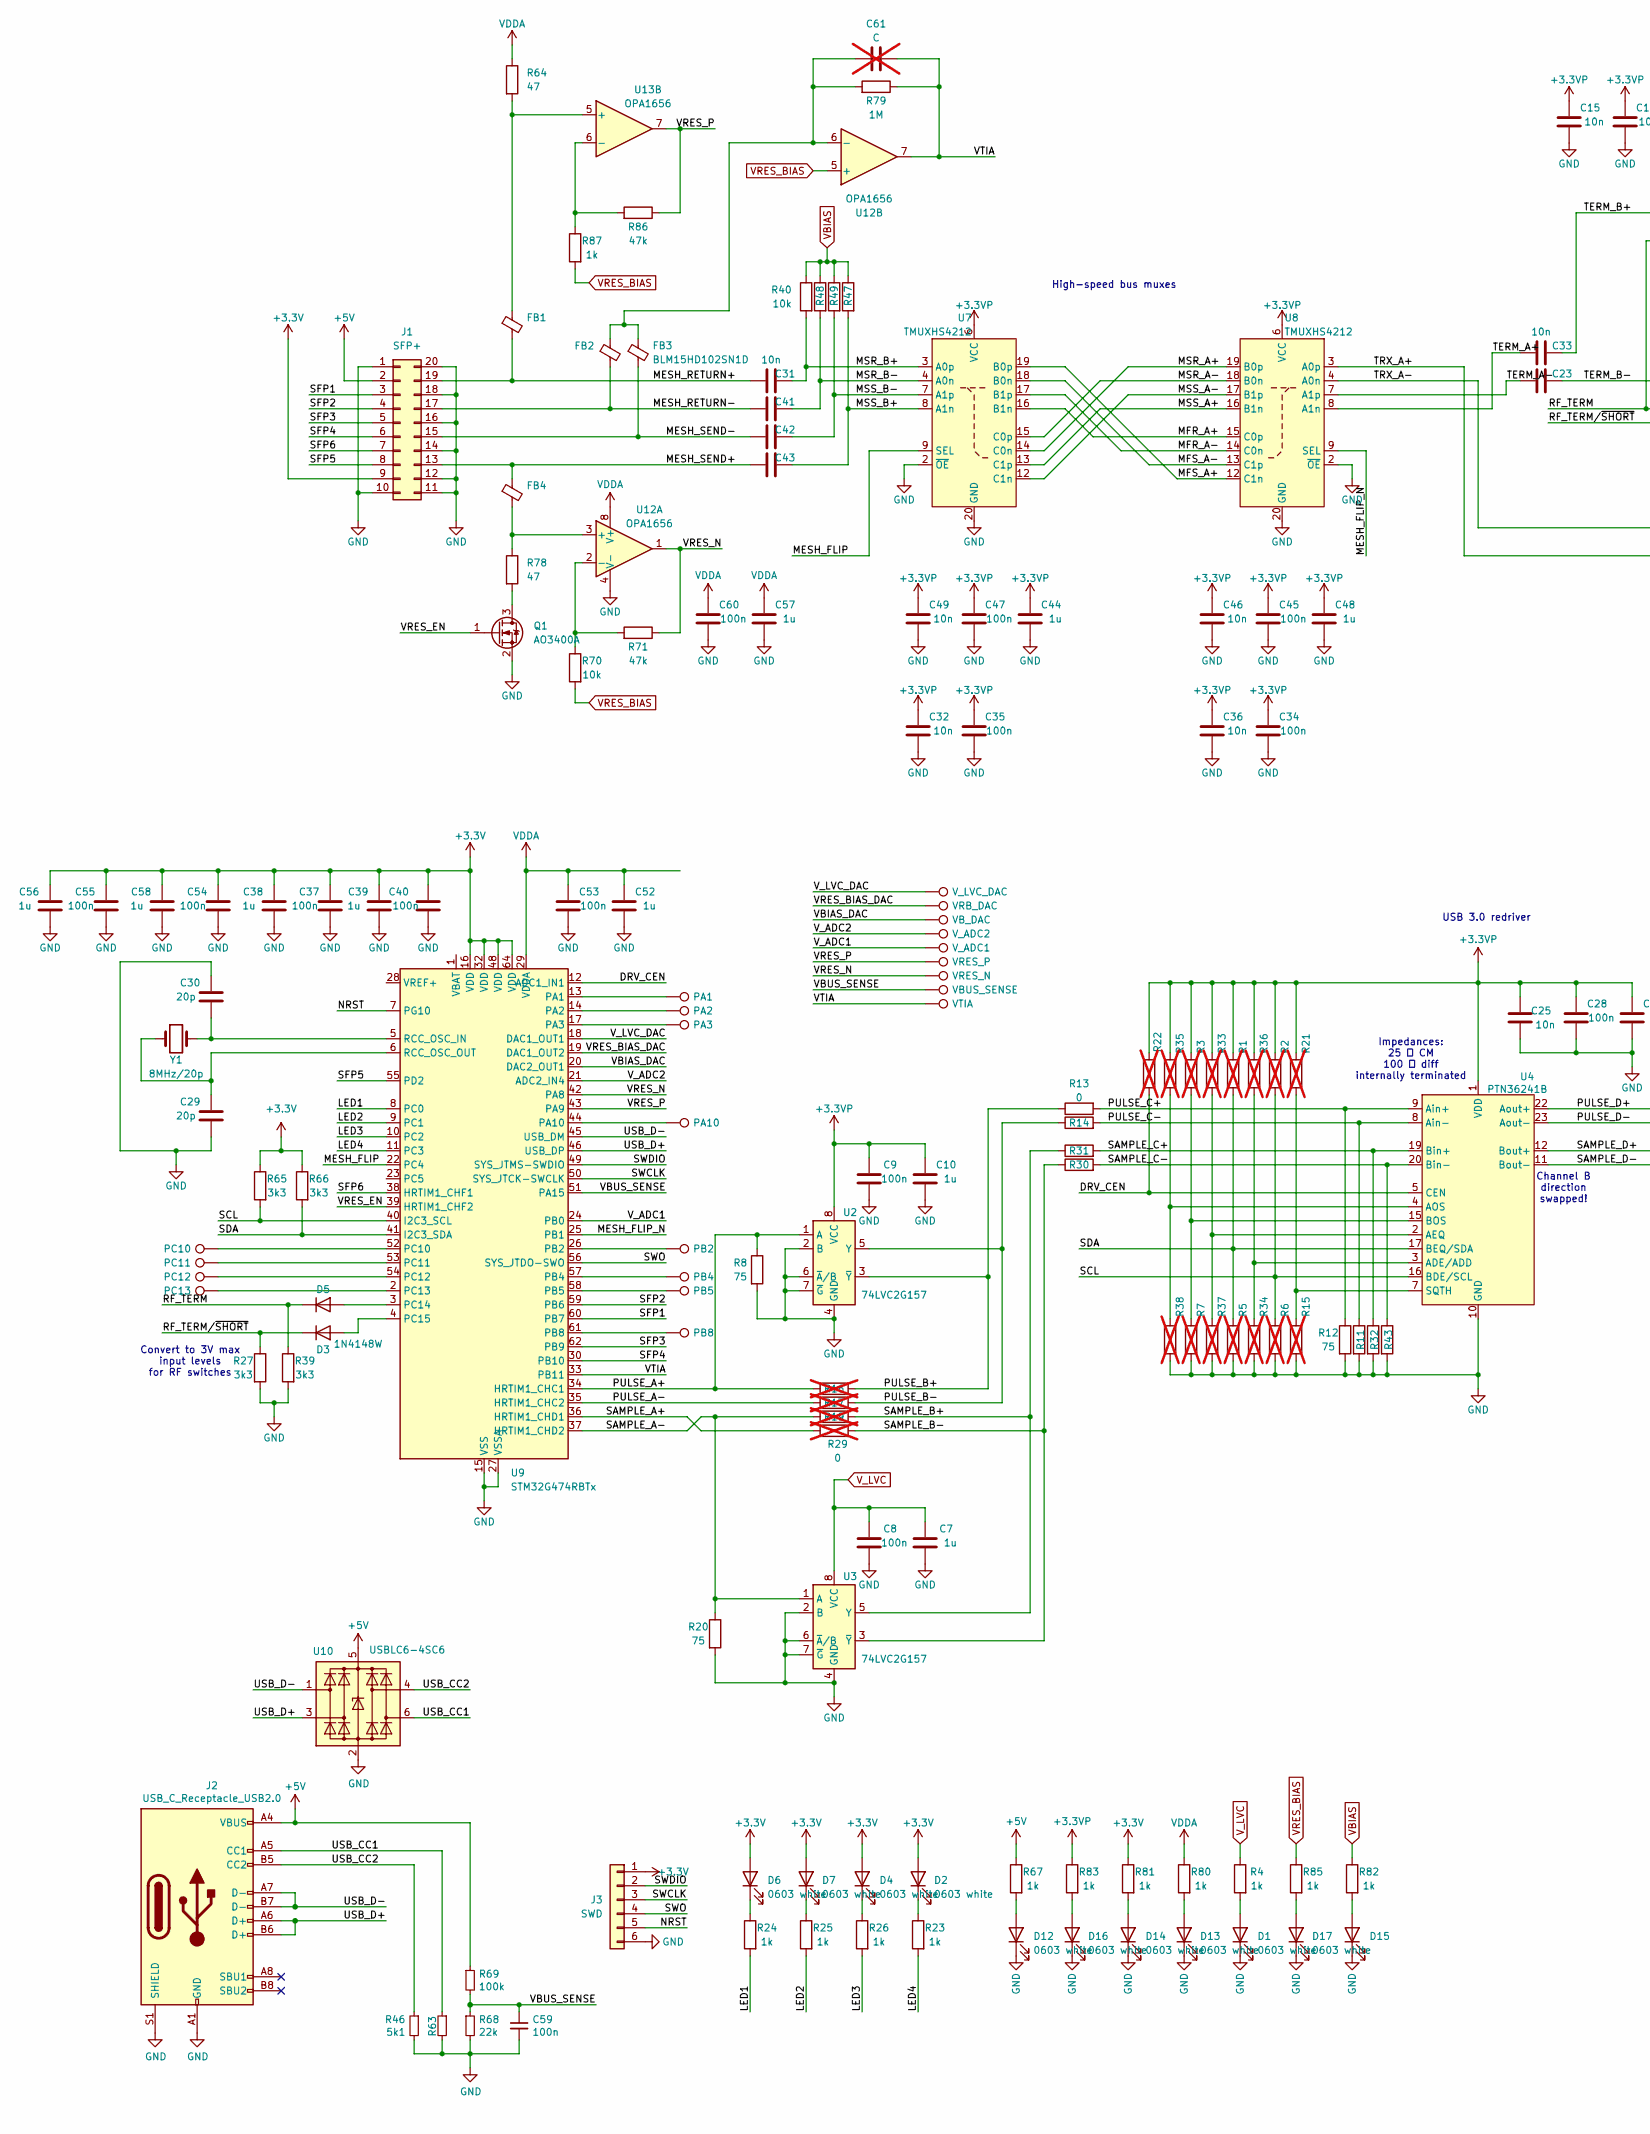
[picture p174: schematic sampling-mesh-monitor.kicad_sch, part in row 1, column 1]

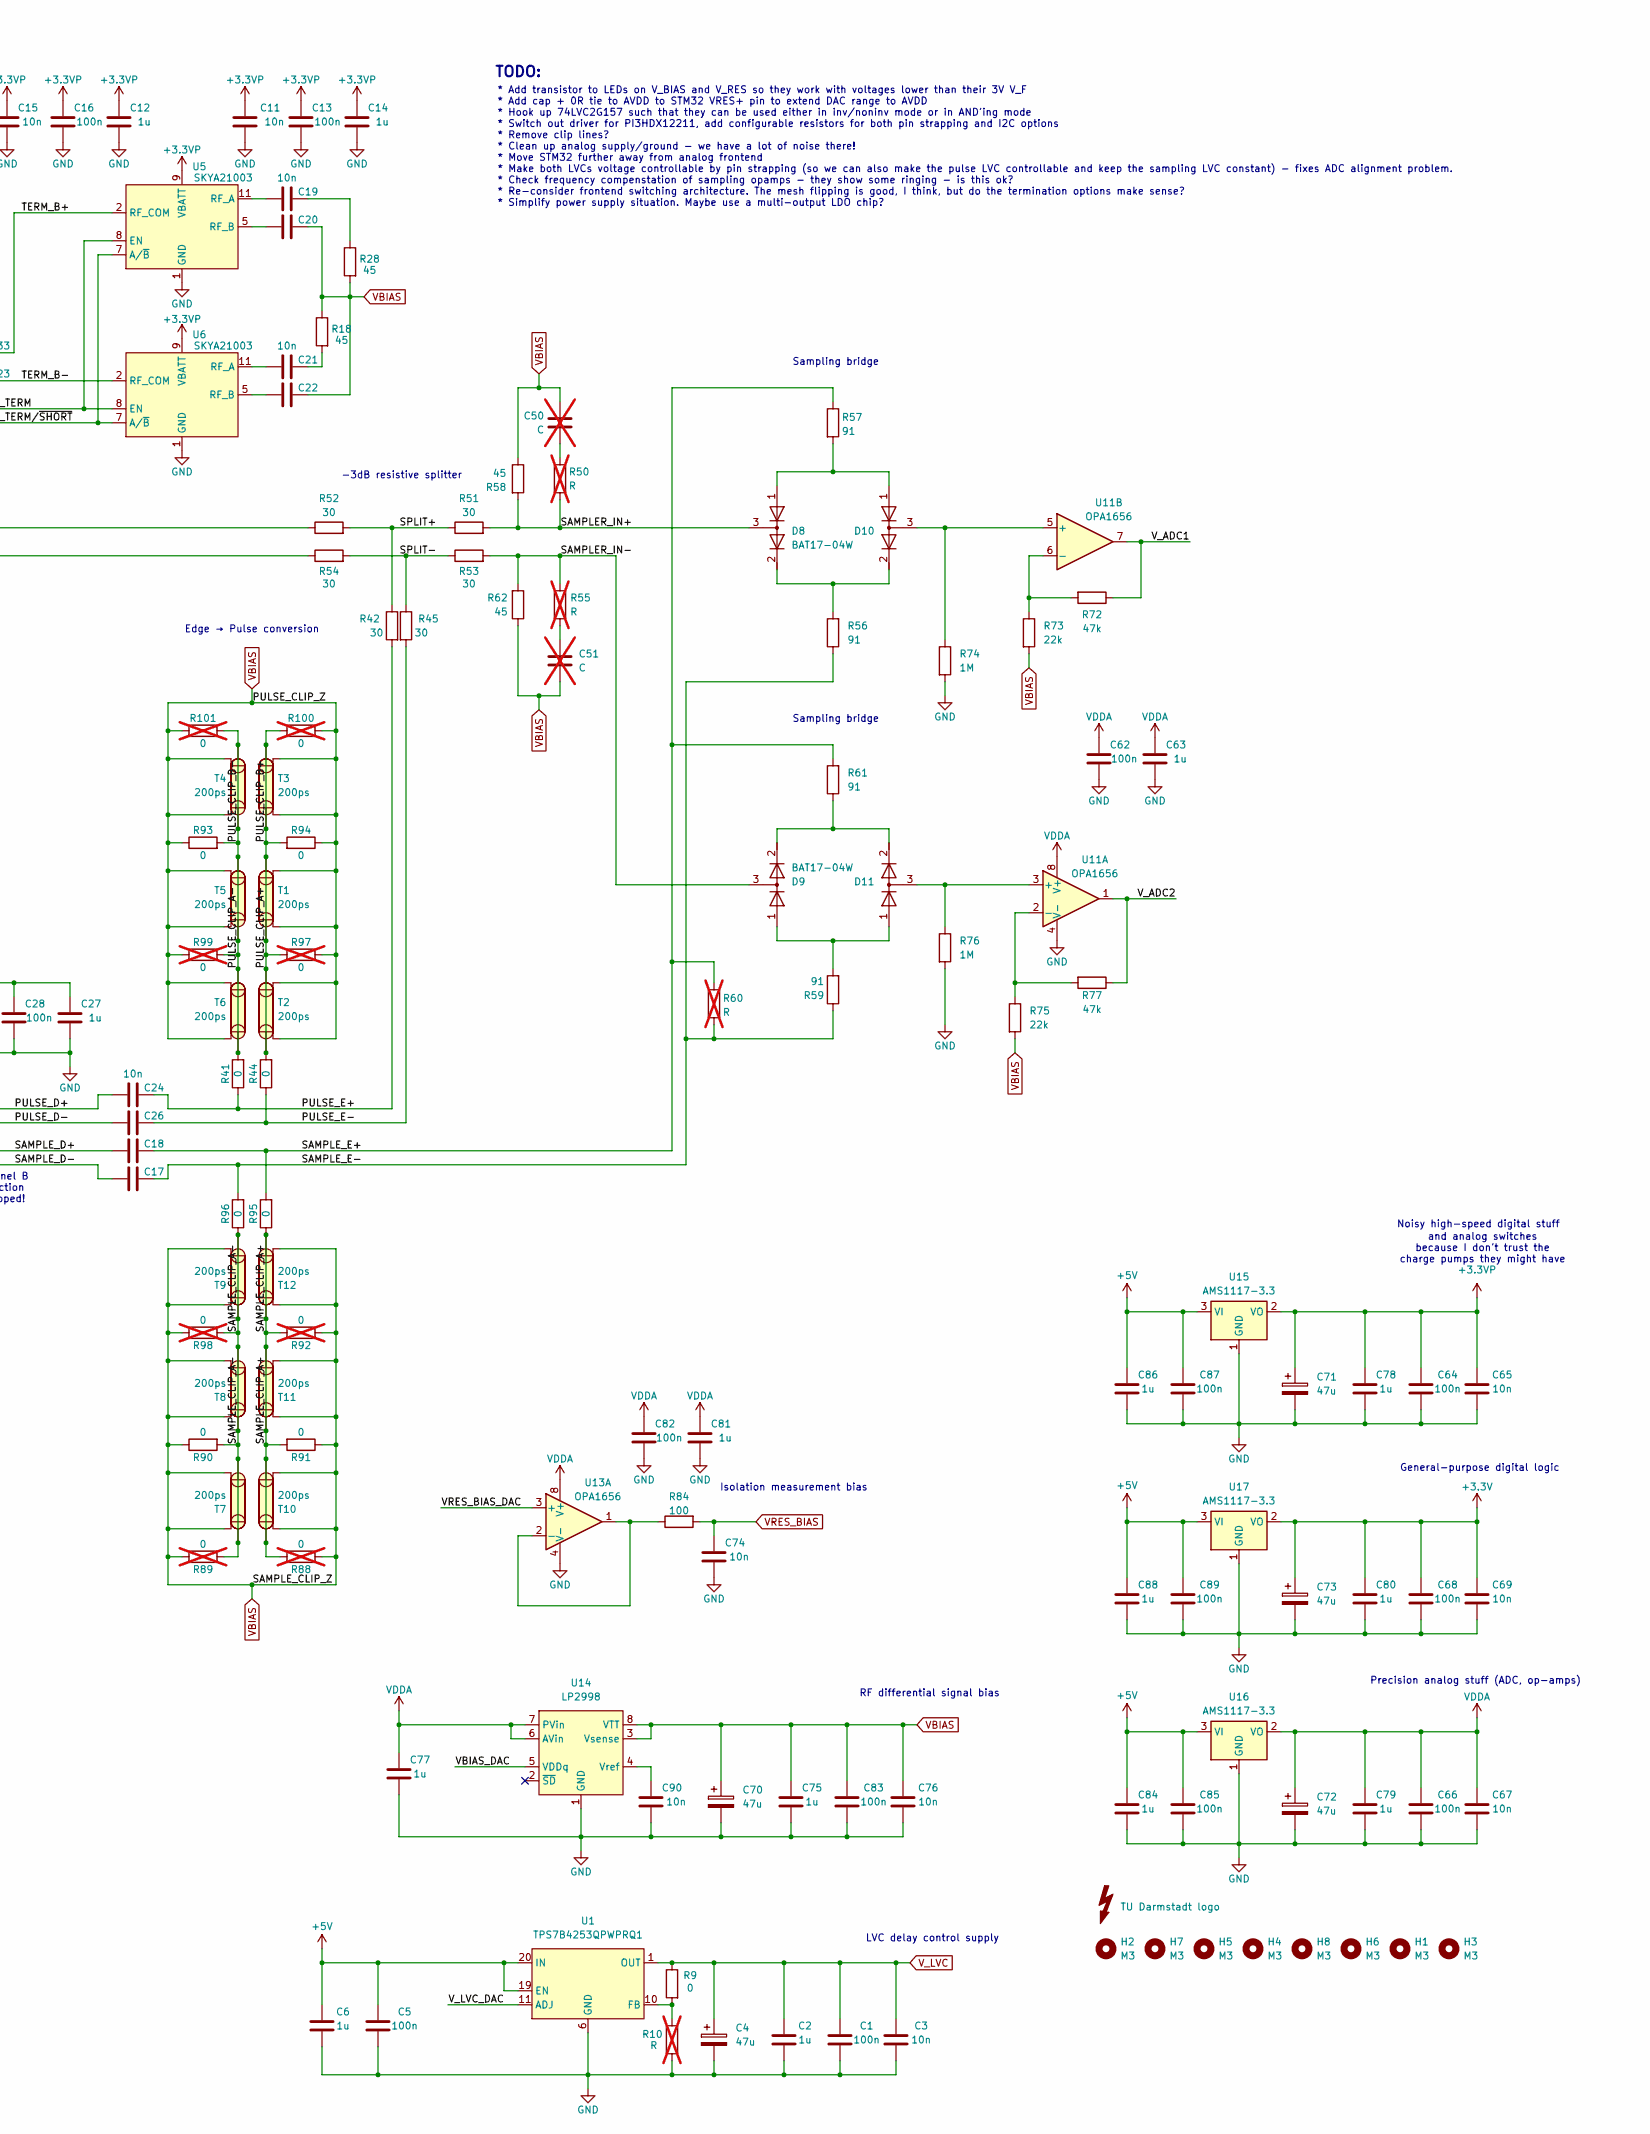
[picture p175: schematic sampling-mesh-monitor.kicad_sch, part in row 1, column 2]

Parts:
C1, C5, C8, C9, C13, C16, C28, C34, C35, C37, C40, C45, C47, C53, C54, C55, C59, C60, C62, C64, C66, C68, C82, C83, C85, C87, C89: 100n; C_0402_1005Metric; LCSC C307331
C2, C6, C7, C10, C12, C14, C27, C38, C39, C44, C48, C52, C56, C57, C58, C63, C75, C77, C78, C79, C80, C81, C84, C86, C88: 1u; C_0805_2012Metric; LCSC C28323
C3, C11, C15, C17, C18, C19, C20, C21, C22, C23, C24, C25, C26, C31, C32, C33, C36, C41, C42, C43, C46, C49, C65, C67, C69, C74, C76, C90: 10n; C_0402_1005Metric; LCSC C15195
C4, C70, C71, C72, C73: 47u; C_Elec_6.3x7.7; LCSC C88810
C29, C30: 20p; C_0402_1005Metric; LCSC C1554
C50, C51, C61: C; C_0402_1005Metric; not fitted
D1, D2, D4, D6, D7, D12, D13, D14, D15, D16, D17: 0603 white; LED_0603_1608Metric; LCSC C2290
D3, D5: 1N4148W; D_SOD-123; LCSC C81598
D8, D9, D10, D11: BAT17-04W; SOT-323_SC-70; LCSC C503474
FB1, FB2, FB3, FB4: BLM15HD102SN1D; L_0402_1005Metric; LCSC C21516
GR1: TU Darmstadt logo; logo_tu_darmstadt_25.0mm
H1, H2, H3, H4, H5, H6, H7, H8: M3; MountingHole_3.2mm_M3_DIN965
J1: SFP+; HCTL_HC-SFP-20P_C2897291; LCSC C2897291
J2: USB_C_Receptacle_USB2.0; USB_C_Receptacle_HCTL_HC-TYPE-C-16P-01A; LCSC C2988369
J3: SWD; Würth_WR-WST_debug_490107670612_2x03_P2.54mm_Vertical
Q1: AO3400A; SOT-23; LCSC C20917
R1, R2, R3, R5, R6, R7, R10, R15, R21, R22, R33, R34, R35, R36, R37, R38, R50, R55, R60: R; R_0402_1005Metric; not fitted
R4, R23, R24, R25, R26, R67, R80, R81, R82, R83, R85, R87: 1k; R_0402_1005Metric; LCSC C11702
R8, R11, R12, R20, R32, R43: 75; R_0402_1005Metric; LCSC C25133
R9, R13, R14, R30, R31, R41, R44, R90, R91, R93, R94, R95, R96: 0; R_0402_1005Metric; LCSC C17168
R16, R17, R19, R29, R88, R89, R92, R97, R98, R99, R100, R101: 0; R_0402_1005Metric; LCSC C17168; not fitted
R18, R28, R58, R62: 45; R_0402_1005Metric; LCSC C327342
R27, R39, R65, R66: 3k3; R_0402_1005Metric; LCSC C25890
R40, R47, R48, R49, R70: 10k; R_0402_1005Metric; LCSC C2654005
R42, R45, R51, R52, R53, R54: 30; R_0402_1005Metric; LCSC C138007
R46, R63: 5k1; R_0402_1005Metric; LCSC C25905
R56, R57, R59, R61: 91; R_0402_1005Metric; LCSC C4071412
R64, R78: 47; R_0603_1608Metric; LCSC C23182
R68, R73, R75: 22k; R_0402_1005Metric; LCSC C25768
R69: 100k; R_0402_1005Metric; LCSC C25741
R71, R72, R77, R86: 47k; R_0402_1005Metric; LCSC C25792
R74, R76, R79: 1M; R_0402_1005Metric; LCSC C138033
R84: 100; R_0402_1005Metric; LCSC C25076
T1, T2, T3, T4, T5, T6, T7, T8, T9, T10, T11, T12: 200ps
TP1: V_LVC_DAC; TestPoint_Pad_1.5x1.5mm
TP2: PA2; TestPoint_Pad_1.5x1.5mm
TP3: PA1; TestPoint_Pad_1.5x1.5mm
TP4: PC13; TestPoint_Pad_1.5x1.5mm
TP5: VRB_DAC; TestPoint_Pad_1.5x1.5mm
TP6: PA3; TestPoint_Pad_1.5x1.5mm
TP7: PB2; TestPoint_Pad_1.5x1.5mm
TP8: PB5; TestPoint_Pad_1.5x1.5mm
TP9: PB8; TestPoint_Pad_1.5x1.5mm
TP10: PC12; TestPoint_Pad_1.5x1.5mm
TP11: PB4; TestPoint_Pad_1.5x1.5mm
TP12: PC11; TestPoint_Pad_1.5x1.5mm
TP13: PC10; TestPoint_Pad_1.5x1.5mm
TP14: PA10; TestPoint_Pad_1.5x1.5mm
TP15: VBUS_SENSE; TestPoint_Pad_1.5x1.5mm
TP16: VRES_N; TestPoint_Pad_1.5x1.5mm
TP17: VTIA; TestPoint_Pad_1.5x1.5mm
TP18: V_ADC1; TestPoint_Pad_1.5x1.5mm
TP19: V_ADC2; TestPoint_Pad_1.5x1.5mm
TP20: VRES_P; TestPoint_Pad_1.5x1.5mm
TP21: VB_DAC; TestPoint_Pad_1.5x1.5mm
U1: TPS7B4253QPWPRQ1; HTSSOP-20-1EP_4.4x6.5mm_P0.65mm_EP3.4x6.5mm_Mask2.4x3.7mm; LCSC C2879376
U2, U3: 74LVC2G157; MSOP-8_3x3mm_P0.65mm; LCSC C78048
U4: PTN36241B; QFN-24-1EP_4x4mm_P0.5mm_EP2.6x2.6mm; LCSC C2675242
U5, U6: SKYA21003; QFN-12_EP_2x2_Pitch0.5mm; LCSC C141440
U7, U8: TMUXHS4212; DHVQFN-20-1EP_2.5x4.5mm_P0.5mm_EP1x3mm; LCSC C3656912
U9: STM32G474RBTx; LQFP-64_10x10mm_P0.5mm; LCSC C529413
U10: USBLC6-4SC6; SOT-23-6; LCSC C558419
U11, U12, U13: OPA1656; SO-8_3.9x4.9mm_P1.27mm; LCSC C1849431
U14: LP2998; SOIC-8-1EP_3.9x4.9mm_P1.27mm_EP2.34x2.34mm; LCSC C181400
U15, U16, U17: AMS1117-3.3; SOT-223-3_TabPin2; LCSC C6186
Y1: 8MHz/20p; Crystal_SMD_5032-2Pin_5.0x3.2mm; LCSC C115962

Connections:
+3.3V: C37.2, C38.2, C39.2, C40.2, C54.2, C55.2, C56.2, C58.2, C68.2, C69.2, C73.1, C80.2, D2.2 (A), D4.2 (A), D6.2 (A), D7.2 (A), J1.9, J3.1, R65.1, R66.1, R81.1, U9.16 (VDD), U9.32 (VDD), U9.48 (VDD), U9.64 (VDD), U17.2 (VO)
+3.3VP: C9.2, C10.2, C11.2, C12.2, C13.2, C14.2, C15.2, C16.2, C25.2, C27.2, C28.2, C32.2, C34.2, C35.2, C36.2, C44.2, C45.2, C46.2, C47.2, C48.2, C49.2, C64.2, C65.2, C71.1, C78.2, R1.1, R2.1, R3.1, R21.1, R22.1, R33.1, R35.1, R36.1, R83.1, U2.8 (VCC), U4.1 (VDD), U4.13 (VDD), U5.9 (VBATT), U6.9 (VBATT), U7.1 (RSVD1), U7.6 (VCC), U7.10 (RSVD2), U8.1 (RSVD1), U8.6 (VCC), U8.10 (RSVD2), U15.2 (VO)
+5V: C5.2, C6.2, C84.2, C85.2, C86.2, C87.2, C88.2, C89.2, J1.2, J2.A4 (VBUS), J2.A9 (VBUS), J2.B4 (VBUS), J2.B9 (VBUS), R67.1, R69.1, U1.19 (EN), U1.20 (IN), U10.5 (VBUS), U15.3 (VI), U16.3 (VI), U17.3 (VI)
/DRV_CEN: R22.2, U4.5 (CEN), U9.12 (ADC1_IN1)
/LED1: R24.2, U9.8 (PC0)
/LED2: R25.2, U9.9 (PC1)
/LED3: R26.2, U9.10 (PC2)
/LED4: R23.2, U9.11 (PC3)
/MESH_FLIP: U7.9 (SEL), U9.22 (PC4)
/MESH_FLIP_N: U8.9 (SEL), U9.25 (PB1)
/MESH_RETURN+: C31.1, FB1.2, J1.19
/MESH_RETURN-: C41.1, FB2.2, J1.17
/MESH_SEND+: C43.1, FB4.1, J1.13
/MESH_SEND-: C42.1, FB3.2, J1.15
/MFR_A+: U7.16 (B1n), U8.15 (C0p)
/MFR_A-: U7.17 (B1p), U8.14 (C0n)
/MFS_A+: U7.19 (B0p), U8.12 (C1n)
/MFS_A-: U7.18 (B0n), U8.13 (C1p)
/MSR_A+: U7.14 (C0n), U8.19 (B0p)
/MSR_A-: U7.15 (C0p), U8.18 (B0n)
/MSR_B+: C31.2, R40.2, U7.3 (A0p)
/MSR_B-: C41.2, R48.2, U7.4 (A0n)
/MSS_A+: U7.13 (C1p), U8.16 (B1n)
/MSS_A-: U7.12 (C1n), U8.17 (B1p)
/MSS_B+: C43.2, R47.2, U7.8 (A1n)
/MSS_B-: C42.2, R49.2, U7.7 (A1p)
/NRST: J3.5, U9.7 (PG10)
/PULSE_A+: R8.1, R16.1, U2.1 (A), U9.34 (HRTIM1_CHC1)
/PULSE_A-: R17.1, U9.35 (HRTIM1_CHC2)
/PULSE_B+: R13.1, R16.2, U2.3 (~Y)
/PULSE_B-: R14.1, R17.2, U2.5 (Y)
/PULSE_C+: R12.1, R13.2, U4.9 (Ain+)
/PULSE_C-: R11.1, R14.2, U4.8 (Ain-)
/PULSE_CLIP_A+: R44.2, R94.2, R97.2, R100.2, T1.1, T1.3, T2.1, T2.3, T3.1, T3.3
/PULSE_CLIP_A-: R41.2, R93.2, R99.2, R101.2, T4.1, T4.3, T5.1, T5.3, T6.1, T6.3
/PULSE_D+: C24.2, U4.22 (Aout+)
/PULSE_D-: C26.2, U4.23 (Aout-)
/PULSE_E+: C24.1, R41.1, R42.2
/PULSE_E-: C26.1, R44.1, R45.2
/RF_TERM: D5.1 (K), R39.1, U5.8 (EN), U6.8 (EN)
/RF_TERM/~SHORT: D3.1 (K), R27.1, U5.7 (A/~B), U6.7 (A/~B)
/SAMPLER_IN+: D8.3 (common), R50.2, R51.2, R58.2
/SAMPLER_IN-: D9.3 (common), R53.2, R55.2, R62.2
/SAMPLE_A+: R29.1, U9.36 (HRTIM1_CHD1)
/SAMPLE_A-: R19.1, R20.1, U3.1 (A), U9.37 (HRTIM1_CHD2)
/SAMPLE_B+: R19.2, R31.1, U3.5 (Y)
/SAMPLE_B-: R29.2, R30.1, U3.3 (~Y)
/SAMPLE_C+: R31.2, R32.1, U4.19 (Bin+)
/SAMPLE_C-: R30.2, R43.1, U4.20 (Bin-)
/SAMPLE_CLIP_A+: R88.2, R91.2, R92.2, R95.1, T10.1, T10.3, T11.1, T11.3, T12.1, T12.3
/SAMPLE_CLIP_A-: R89.2, R90.2, R96.1, R98.2, T7.1, T7.3, T8.1, T8.3, T9.1, T9.3
/SAMPLE_D+: C18.2, U4.12 (Bout+)
/SAMPLE_D-: C17.2, U4.11 (Bout-)
/SAMPLE_E+: C18.1, R57.1, R60.1, R61.2, R95.2
/SAMPLE_E-: C17.1, R56.1, R59.1, R60.2, R96.2
/SCL: R2.2, R6.1, R65.2, U4.16 (BDE/SCL), U9.40 (I2C3_SCL)
/SDA: R1.2, R5.1, R66.2, U4.17 (BEQ/SDA), U9.41 (I2C3_SDA)
/SFP1: J1.3, U9.60 (PB7)
/SFP2: J1.4, U9.59 (PB6)
/SFP3: J1.5, U9.62 (PB9)
/SFP4: J1.6, U9.30 (PB10)
/SFP5: J1.8, U9.55 (PD2)
/SFP6: J1.7, U9.38 (HRTIM1_CHF1)
/SPLIT+: R42.1, R51.1, R52.2
/SPLIT-: R45.1, R53.1, R54.2
/SWCLK: J3.3, U9.50 (SYS_JTCK-SWCLK)
/SWDIO: J3.2, U9.49 (SYS_JTMS-SWDIO)
/SWO: J3.4, U9.56 (SYS_JTDO-SWO)
/TERM_A+: C33.2, U8.8 (A1n)
/TERM_A-: C23.2, U8.7 (A1p)
/TERM_B+: C33.1, U5.2 (RF_COM)
/TRX_A+: R54.1, U8.3 (A0p)
/TRX_A-: R52.1, U8.4 (A0n)
/USB_CC1: J2.A5 (CC1), R63.1, U10.6 (I/O4)
/USB_CC2: J2.B5 (CC2), R46.1, U10.4 (I/O3)
/USB_D+: J2.A6 (D+), J2.B6 (D+), U9.46 (USB_DP), U10.3 (I/O2)
/USB_D-: J2.A7 (D-), J2.B7 (D-), U9.45 (USB_DM), U10.1 (I/O1)
/VBIAS_DAC: TP21.1, U9.20 (DAC2_OUT1), U14.5 (VDDq)
/VBUS_SENSE: C59.1, R68.1, R69.2, TP15.1, U9.51 (PA15)
/VRES_BIAS_DAC: TP5.1, U9.19 (DAC1_OUT2), U13.3 (+)
/VRES_EN: Q1.1 (G), U9.39 (HRTIM1_CHF2)
/VRES_N: R71.1, TP16.1, U9.42 (PA8), U12.1
/VRES_P: R86.1, TP20.1, U9.43 (PA9), U13.7
/VTIA: C61.2, R79.1, TP17.1, U9.33 (PB11), U12.7
/V_ADC1: R72.1, TP18.1, U9.24 (PB0), U11.7
/V_ADC2: R77.1, TP19.1, U9.21 (ADC2_IN4), U11.1
/V_LVC_DAC: TP1.1, U1.11 (ADJ), U9.18 (DAC1_OUT1)
GND: C1.1, C2.1, C3.1, C4.2, C5.1, C6.1, C7.1, C8.1, C9.1, C10.1, C11.1, C12.1, C13.1, C14.1, C15.1, C16.1, C25.1, C27.1, C28.1, C29.1, C30.2, C32.1, C34.1, C35.1, C36.1, C37.1, C38.1, C39.1, C40.1, C44.1, C45.1, C46.1, C47.1, C48.1, C49.1, C52.1, C53.1, C54.1, C55.1, C56.1, C57.1, C58.1, C59.2, C60.1, C62.1, C63.1, C64.1, C65.1, C66.1, C67.1, C68.1, C69.1, C70.2, C71.2, C72.2, C73.2, C74.1, C75.1, C76.1, C77.1, C78.1, C79.1, C80.1, C81.1, C82.1, C83.1, C84.1, C85.1, C86.1, C87.1, C88.1, C89.1, C90.1, D1.1 (K), D12.1 (K), D13.1 (K), D14.1 (K), D15.1 (K), D16.1 (K), D17.1 (K), J1.1, J1.10, J1.11, J1.12, J1.14, J1.16, J1.18, J1.20, J2.A1 (GND), J2.A12 (GND), J2.B1 (GND), J2.B12 (GND), J2.S1 (SHIELD), J3.6, Q1.2 (S), R5.2, R6.2, R7.2, R8.2, R10.2, R11.2, R12.2, R15.2, R20.2, R27.2, R32.2, R34.2, R37.2, R38.2, R39.2, R43.2, R46.2, R63.2, R68.2, R74.2, R76.2, U1.6 (GND), U1.15 (GND), U1.21 (GND), U2.2 (B), U2.4 (GND), U2.6 (~A/B), U2.7 (~G), U3.2 (B), U3.4 (GND), U3.6 (~A/B), U3.7 (~G), U4.6 (GND), U4.10 (GND), U4.14 (RES), U4.18 (GND), U4.21 (GND), U4.25 (GND), U5.1 (GND), U5.3 (GND), U5.4 (GND), U5.6 (GND), U5.10 (GND), U5.12 (GND), U5.13 (GND), U6.1 (GND), U6.3 (GND), U6.4 (GND), U6.6 (GND), U6.10 (GND), U6.12 (GND), U6.13 (GND), U7.2 (~OE), U7.5 (GND), U7.11 (GND), U7.20 (GND), U7.21 (GND), U8.2 (~OE), U8.5 (GND), U8.11 (GND), U8.20 (GND), U8.21 (GND), U9.15 (VSS), U9.27 (VSSA), U9.31 (VSS), U9.47 (VSS), U9.63 (VSS), U10.2 (GND), U11.4 (V-), U12.4 (V-), U13.4 (V-), U14.1 (GND), U14.9 (GND), U15.1 (GND), U16.1 (GND), U17.1 (GND)
unnamed: C50.2, R50.1
unnamed: C19.1, R28.1
unnamed: C21.1, R18.2
unnamed: C51.1, R55.1
unnamed: D8.1 (A), D10.1 (A), R57.2
unnamed: D8.2 (K), D10.2 (K), R56.2
unnamed: D10.3 (common), R74.1, U11.5 (+)
unnamed: D9.1 (A), D11.1 (A), R59.2
unnamed: D9.2 (K), D11.2 (K), R61.1
unnamed: D11.3 (common), R76.1, U11.3 (+)
unnamed: D5.2 (A), U9.3 (PC14)
unnamed: D3.2 (A), U9.4 (PC15)
unnamed: D7.1 (K), R25.1
unnamed: D6.1 (K), R24.1
unnamed: D4.1 (K), R26.1
unnamed: D2.1 (K), R23.1
unnamed: D12.2 (A), R67.2
unnamed: D16.2 (A), R83.2
unnamed: D14.2 (A), R81.2
unnamed: D13.2 (A), R80.2
unnamed: D1.2 (A), R4.2
unnamed: D17.2 (A), R85.2
unnamed: D15.2 (A), R82.2
unnamed: Q1.3 (D), R78.2
unnamed: FB4.2, R78.1, U12.3 (+)
unnamed: R70.1, R71.2, U12.2 (-)
unnamed: C61.1, FB2.1, FB3.1, R79.2, U12.6 (-)
unnamed: R84.1, U13.1, U13.2 (-)
unnamed: FB1.1, R64.2, U13.5 (+)
unnamed: R86.2, R87.1, U13.6 (-)
unnamed: C90.2, U14.4 (Vref)
unnamed: R34.1, R36.2, U4.3 (ADE/ADD)
unnamed: R33.2, R37.1, U4.2 (AEQ)
unnamed: R35.2, R38.1, U4.4 (AOS)
unnamed: R3.2, R7.1, U4.15 (BOS)
unnamed: R15.1, R21.2, U4.7 (SQTH)
unnamed: TP3.1, U9.13 (PA1)
unnamed: TP2.1, U9.14 (PA2)
unnamed: TP6.1, U9.17 (PA3)
unnamed: TP14.1, U9.44 (PA10)
unnamed: TP7.1, U9.26 (PB2)
unnamed: TP11.1, U9.57 (PB4)
unnamed: TP8.1, U9.58 (PB5)
unnamed: TP9.1, U9.61 (PB8)
unnamed: TP13.1, U9.52 (PC10)
unnamed: TP12.1, U9.53 (PC11)
unnamed: TP10.1, U9.54 (PC12)
unnamed: TP4.1, U9.2 (PC13)
unnamed: C30.1, U9.5 (RCC_OSC_IN), Y1.2
unnamed: C29.2, U9.6 (RCC_OSC_OUT), Y1.1
unnamed: C19.2, U5.11 (RF_A)
unnamed: C20.2, U5.5 (RF_B)
unnamed: C21.2, U6.11 (RF_A)
unnamed: C22.2, U6.5 (RF_B)
unnamed: C23.1, U6.2 (RF_COM)
unnamed: R75.1, R77.2, U11.2 (-)
unnamed: R72.2, R73.1, U11.6 (-)
unnamed: R9.2, R10.1, U1.10 (FB)
VBIAS: C20.1, C22.1, C50.1, C51.2, C70.1, C75.2, C76.2, C83.2, R18.1, R28.2, R40.1, R47.1, R48.1, R49.1, R58.1, R62.1, R73.2, R75.2, R82.1, R88.1, R89.1, R90.1, R91.1, R92.1, R93.1, R94.1, R97.1, R98.1, R99.1, R100.1, R101.1, T1.2, T1.4, T2.2, T2.4, T3.2, T3.4, T4.2, T4.4, T5.2, T5.4, T6.2, T6.4, T7.2, T7.4, T8.2, T8.4, T9.2, T9.4, T10.2, T10.4, T11.2, T11.4, T12.2, T12.4, U14.3 (Vsense), U14.8 (VTT)
VDDA: C52.2, C53.2, C57.2, C60.2, C62.2, C63.2, C66.2, C67.2, C72.1, C77.2, C79.2, C81.2, C82.2, R64.1, R80.1, U9.29 (VDDA), U11.8 (V+), U12.8 (V+), U13.8 (V+), U14.6 (AVin), U14.7 (PVin), U16.2 (VO)
VRES_BIAS: C74.2, R70.2, R84.2, R85.1, R87.2, U12.5 (+)
V_LVC: C1.2, C2.2, C3.2, C4.1, C7.2, C8.2, R4.1, R9.1, U1.1 (OUT), U3.8 (VCC)

Notes on the sheet:
General-purpose digital logic
and analog switches because I don't trust the charge pumps they might have
-3dB resistive splitter
Isolation measurement bias
Edge → Pulse conversion
Sampling bridge
USB 3.0 redriver
Channel B direction swapped!
RF differential signal bias
High-speed bus muxes
* Add transistor to LEDs on V_BIAS and V_RES so they work with voltages lower than their 3V V_F * Add cap + 0R tie to AVDD to STM32 VRES+ pin to extend DAC range to AVDD * Hook up 74LVC2G157 such that they can be used either in inv/noninv mode or in AND'ing mode * Switch out driver for PI3HDX12211,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
Precision analog stuff (ADC, op-amps)
LVC delay control supply
Noisy high-speed digital stuff
TODO:
Convert to 3V max input levels for RF switches
Impedances: 25  CM 100  diff internally terminated

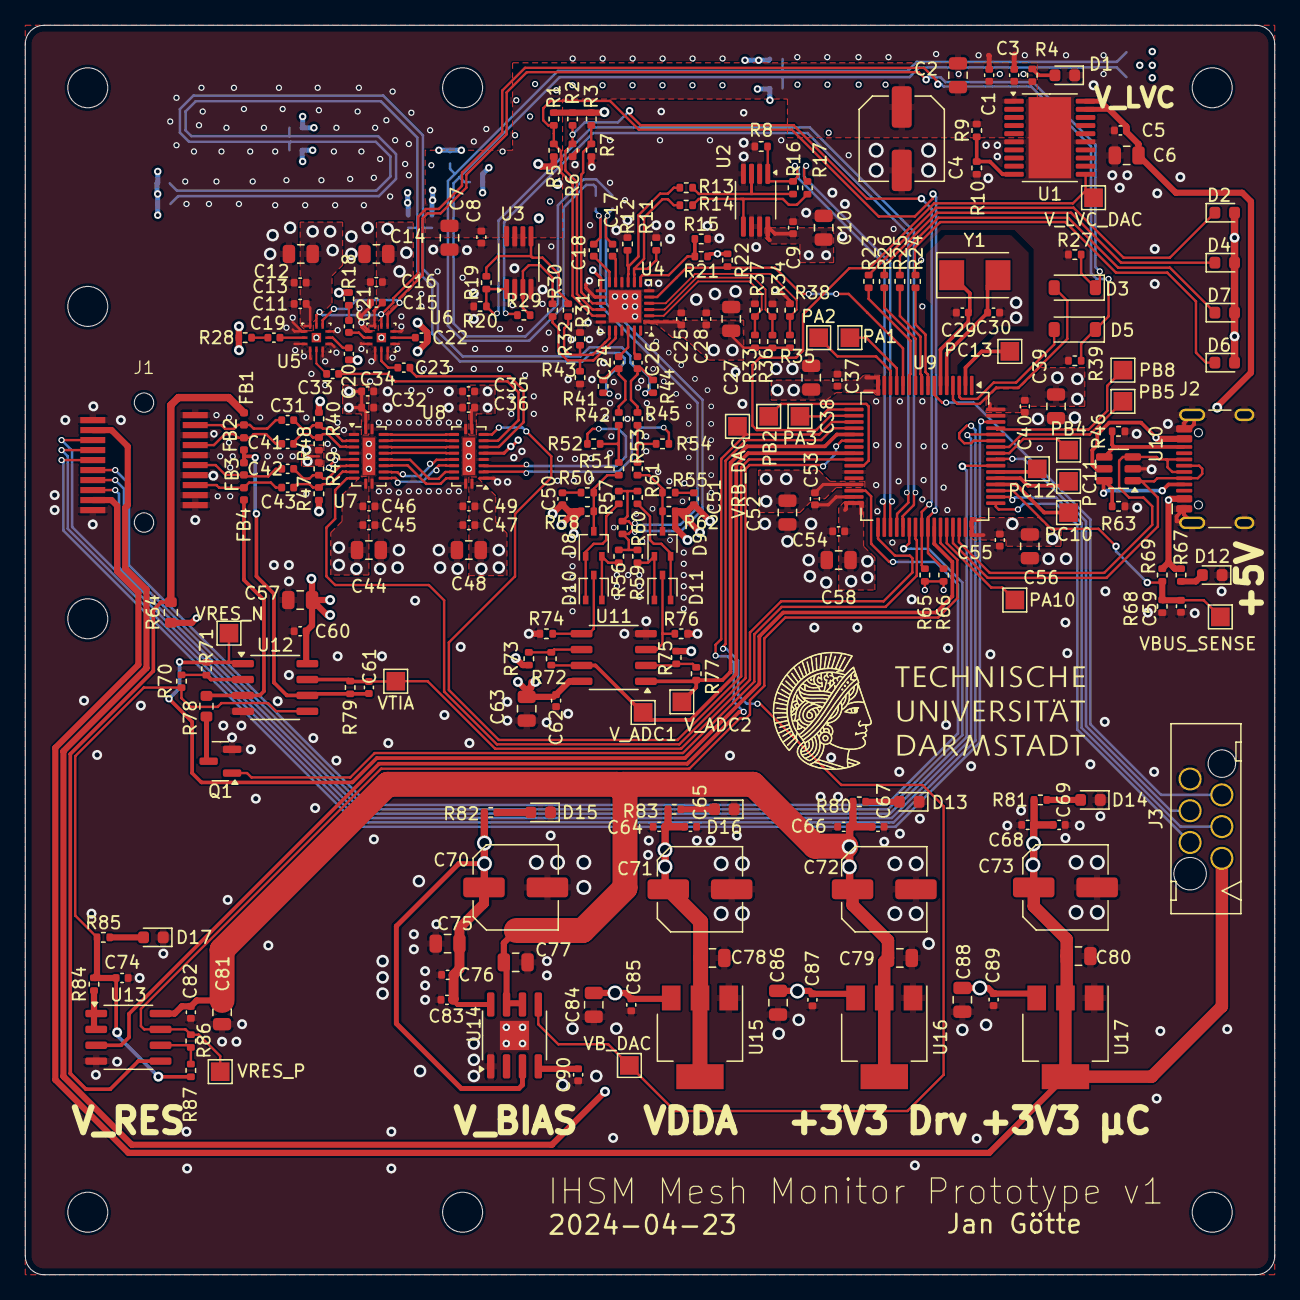
[picture p176: board sampling-mesh-monitor.kicad_pcb from above]

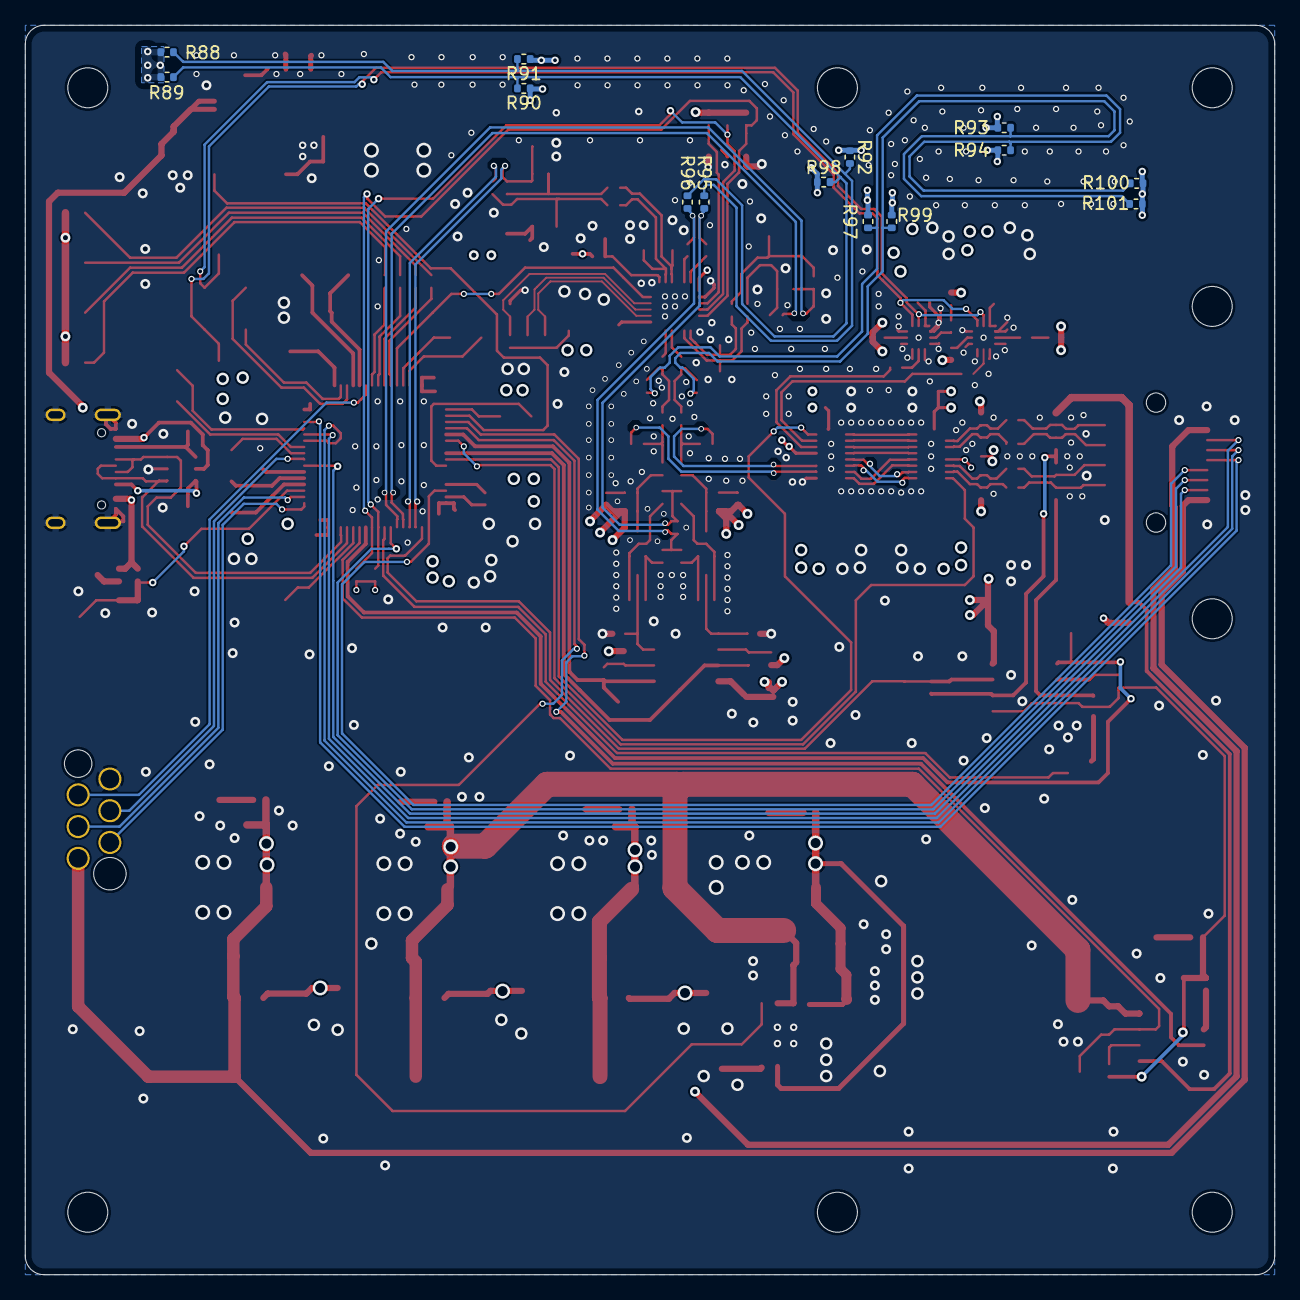
[picture p177: board sampling-mesh-monitor.kicad_pcb from below]

Board: 15 copper layers, 100.0 x 100.0 mm, 264 parts (14 on the bottom side), 150 nets.
