jaseg/sampling-mesh-monitor/test_coupons/uut_mesh_board_cal/uut_mesh_board_cal.kicad_pcb

## KiCad design test_coupons/uut_mesh_board_cal/uut_mesh_board_cal.kicad_pcb (2024-04-24)

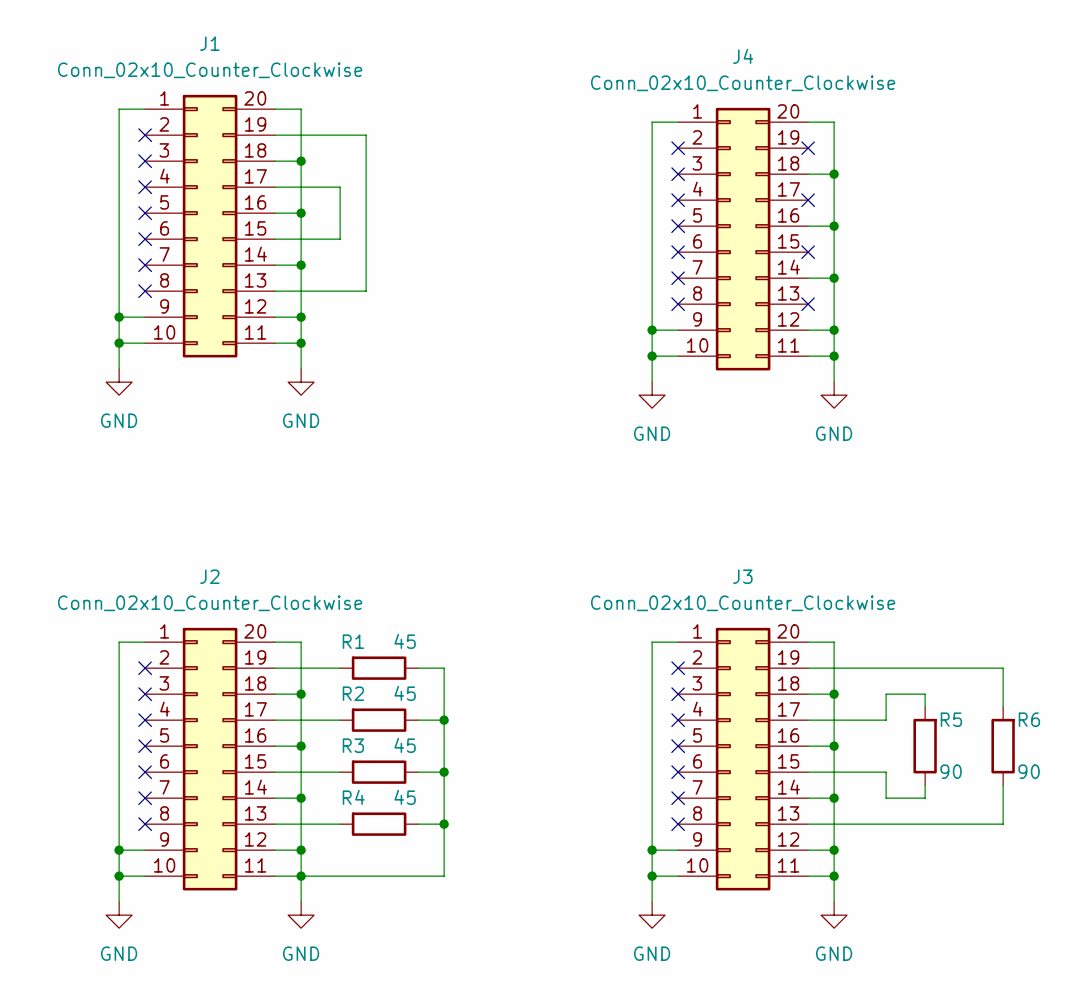
[picture p178: schematic uut_mesh_board_cal.kicad_sch]

Parts:
J1, J2, J3, J4: Conn_02x10_Counter_Clockwise; sfp_edge_connector_male
R1, R2, R3, R4: 45; R_0603_1608Metric
R5, R6: 90; R_0603_1608Metric

Connections:
GND: J1.1, J1.9, J1.10, J1.11, J1.12, J1.14, J1.16, J1.18, J1.20, J2.1, J2.9, J2.10, J2.11, J2.12, J2.14, J2.16, J2.18, J2.20, J3.1, J3.9, J3.10, J3.11, J3.12, J3.14, J3.16, J3.18, J3.20, J4.1, J4.9, J4.10, J4.11, J4.12, J4.14, J4.16, J4.18, J4.20, R1.1, R2.1, R3.1, R4.1
unnamed: J1.13, J1.19
unnamed: J1.15, J1.17
unnamed: J2.13, R4.2
unnamed: J2.15, R3.2
unnamed: J2.17, R2.2
unnamed: J2.19, R1.2
unnamed: J3.13, R6.1
unnamed: J3.15, R5.1
unnamed: J3.17, R5.2
unnamed: J3.19, R6.2

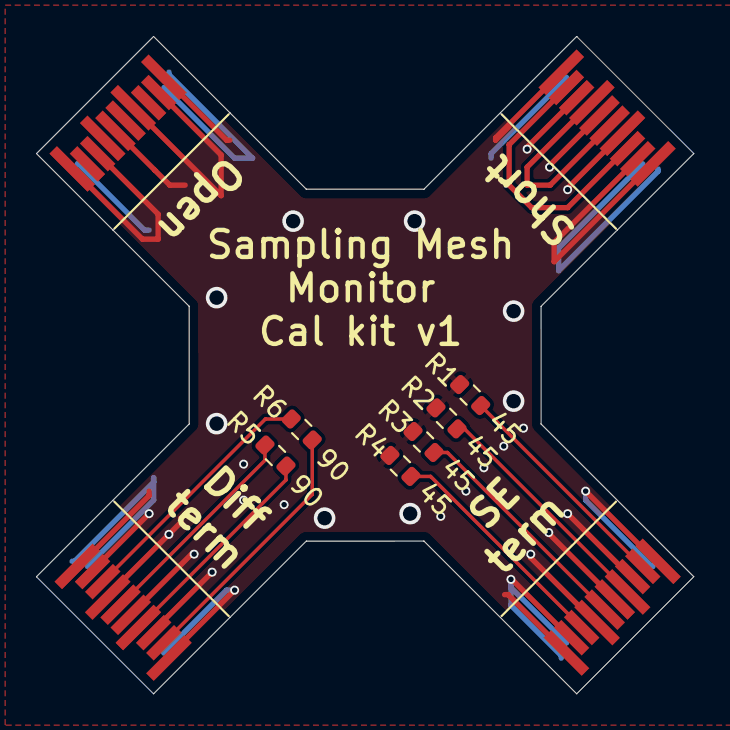
[picture p179: board uut_mesh_board_cal.kicad_pcb from above]

Board: 2 copper layers, 36.5 x 36.5 mm, 11 parts (1 on the bottom side), 11 nets.

Other parts of the board:
logo_tu_darmstadt_15.0mm: G*****; logo_tu_darmstadt_15.0mm
