jaseg/sampling-mesh-monitor/firmware/system.c

#include <global.h>
#include <stm32g4xx.h>

uint32_t SystemCoreClock = HSI_VALUE;
const uint8_t AHBPrescTable[16] = {0U, 0U, 0U, 0U, 0U, 0U, 0U, 0U, 1U, 2U, 3U, 4U, 6U, 7U, 8U, 9U};
const uint8_t APBPrescTable[8] =  {0U, 0U, 0U, 0U, 1U, 2U, 3U, 4U};

void SystemInit()
{
    SCB->CPACR |= ((3UL << (10*2))|(3UL << (11*2)));  /* set CP10 and CP11 Full Access */
    SCB->VTOR = FLASH_BASE; /* Vector Table Relocation in Internal FLASH */
}

/**
  * @brief  Update SystemCoreClock variable according to Clock Register Values.
  *         The SystemCoreClock variable contains the core clock (HCLK), it can
  *         be used by the user application to setup the SysTick timer or configure
  *         other parameters.
  *
  * @note   Each time the core clock (HCLK) changes, this function must be called
  *         to update SystemCoreClock variable value. Otherwise, any configuration
  *         based on this variable will be incorrect.
  *
  * @note   - The system frequency computed by this function is not the real
  *           frequency in the chip. It is calculated based on the predefined
  *           constant and the selected clock source:
  *
  *           - If SYSCLK source is HSI, SystemCoreClock will contain the HSI_VALUE(**)
  *
  *           - If SYSCLK source is HSE, SystemCoreClock will contain the HSE_VALUE(***)
  *
  *           - If SYSCLK source is PLL, SystemCoreClock will contain the HSE_VALUE(***)
  *             or HSI_VALUE(*) multiplied/divided by the PLL factors.
  *
  *         (**) HSI_VALUE is a constant defined in stm32g4xx_hal.h file (default value
  *              16 MHz) but the real value may vary depending on the variations
  *              in voltage and temperature.
  *
  *         (***) HSE_VALUE is a constant defined in stm32g4xx_hal.h file (default value
  *              24 MHz), user has to ensure that HSE_VALUE is same as the real
  *              frequency of the crystal used. Otherwise, this function may
  *              have wrong result.
  *
  *         - The result of this function could be not correct when using fractional
  *           value for HSE crystal.
  *
  * @param  None
  * @retval None
  */
void SystemCoreClockUpdate()
{
  uint32_t tmp, pllvco, pllr, pllsource, pllm;

  /* Get SYSCLK source -------------------------------------------------------*/
  switch (RCC->CFGR & RCC_CFGR_SWS)
  {
    case 0x04:  /* HSI used as system clock source */
      SystemCoreClock = HSI_VALUE;
      break;

    case 0x08:  /* HSE used as system clock source */
      SystemCoreClock = HSE_VALUE;
      break;

    case 0x0C:  /* PLL used as system clock  source */
      /* PLL_VCO = (HSE_VALUE or HSI_VALUE / PLLM) * PLLN
         SYSCLK = PLL_VCO / PLLR
         */
      pllsource = (RCC->PLLCFGR & RCC_PLLCFGR_PLLSRC);
      pllm = ((RCC->PLLCFGR & RCC_PLLCFGR_PLLM) >> 4) + 1U ;
      if (pllsource == 0x02UL) /* HSI used as PLL clock source */
      {
        pllvco = (HSI_VALUE / pllm);
      }
      else                   /* HSE used as PLL clock source */
      {
        pllvco = (HSE_VALUE / pllm);
      }
      pllvco = pllvco * ((RCC->PLLCFGR & RCC_PLLCFGR_PLLN) >> 8);
      pllr = (((RCC->PLLCFGR & RCC_PLLCFGR_PLLR) >> 25) + 1U) * 2U;
      SystemCoreClock = pllvco/pllr;
      break;

    default:
      break;
  }
  /* Compute HCLK clock frequency --------------------------------------------*/
  /* Get HCLK prescaler */
  tmp = AHBPrescTable[((RCC->CFGR & RCC_CFGR_HPRE) >> 4)];
  /* HCLK clock frequency */
  SystemCoreClock >>= tmp;
}
