jaseg/sampling-mesh-monitor/(commit log)

2024-04-24 Initial commmit
    [sampling-mesh-monitor.kicad_pcb, sampling-mesh-monitor.kicad_sch]
2024-04-24 PCB almost finished
    [sampling-mesh-monitor.kicad_pcb, sampling-mesh-monitor.kicad_sch]
2024-04-24 Reannotate reference designators by PCB location
    [sampling-mesh-monitor.kicad_pcb, sampling-mesh-monitor.kicad_sch]
2024-04-24 Add cal kit UUT
    [sampling-mesh-monitor.kicad_pcb, sampling-mesh-monitor.kicad_sch, uut_mesh_board_cal.kicad_pcb, uut_mesh_board_cal.kicad_sch]
2024-04-24 uut/cal kit: Add version number
    [uut_mesh_board_cal.kicad_pcb]
2024-04-24 uut/mesh: Add mesh uut
    [uut_meshes.kicad_pcb, uut_meshes.kicad_sch]
2024-04-25 Mesh test board WIP
    [uut_meshes.kicad_pcb, uut_meshes.kicad_sch]
2024-04-25 meshes WIP
    [uut_meshes.kicad_pcb, uut_meshes.kicad_sch]
2024-11-20 We get first, very rough sampled measurements
2024-11-22 I2C wasn't working, with pin-strapped driver config we now get some *very* spicy edges it seems
    This commit also scales the web UI plots' X axis in ns and Y axis in V.
2024-11-23 Add todos to board schematic
    [sampling-mesh-monitor.kicad_pcb, sampling-mesh-monitor.kicad_sch, uut_meshes.kicad_pcb, uut_meshes.kicad_sch]
2024-11-23 Move stimulus instead of sampling pulse, eliminates ADC alignment issue
    The ADC can only trigger on whole clock pulses, so when we move the
    sampling pulse in fractional increments, the relative alignment of the
    ADC's sampling phase w.r.t. sampling pulse moves around +/-0.5 clock
    periods. Since our opamps ring a bit, that leads to an artifact in the
    measurements with a period of 32 samples (one whole clock pulse). Moving
    the stimulus pulse instead fixes this issue, as now the alignment
    between the sampling pulse and the ADC's sampling is constant.
    [main.c]
2024-11-23 Something weird is happening with the hrtim master period
    This new value gives much cleaner curves. I suspect that either we have
    some issue with ADC sampling not being precise due to clock domain
    crossings, or this is just interference and the new period hits a sweet
    spot that is coherent with this interference.
    [main.c]
2024-11-26 It's roughly doing what it's supposed to do now.
    We have mystery oscillations.
    [adc_serve.py, main.c]
2025-01-28 Add input clamping diodes
2025-01-29 Add spectrum measurement results
    [amp_out_span_2g.csv, amp_out_span_2g_rbw_10k_40kpt_0000.csv, board_out_span_2g_rbw_10k_40kpt.csv]
2025-02-07 fw: Fix aliasing issue, improve web IF
    [adc_serve.py, main.c]
2025-03-10 paper: Text on mesh related work and circuit design
2025-03-27 Add repeated measurements for broken board and for risetime tuning
    [sampling-mesh-monitor.kicad_sch]
2025-03-31 Improve probe shape plots
2025-03-31 Update probe plot
2025-04-02 Add mesh length calculation and visualization tool
    [uut_meshes.kicad_pcb]
2025-04-02 Enable spectrum measurement mode
    Revert "Undo temporary spectrum measurement changes"
    This reverts commit a2d95a324ae03bfd388dcb72b759d3f698038c32.
    [main.c]
2025-04-03 Add new spectrum measurements
    [74lvc_bent_1.csv, 74lvc_straight_1.csv, max3748_bent_1.csv, max3748_straight_1.csv, pi3hdx_bent_1.csv, pi3hdx_bent_2.csv, pi3hdx_straight_1.csv, tdp0604_bent_1.csv]
2025-04-03 Update trace plot alignment
2025-04-03 Add missing spectrum data
    [74lvc_bent_3.csv, max3748_bent_3.csv, pi3hdx_bent_3.csv, tdp0604_bent_3.csv]
2025-04-09 Revert "Enable spectrum measurement mode"
    This reverts commit f335d96c4f549d39098c66153fe3a72ebb055d40.
    [main.c]
2025-04-10 Clean up duplicate fields in printed bibliography
2025-06-17 Add new mesh coupons
    [uut_meshes.kicad_pcb, uut_meshes.kicad_sch]
2025-06-23 Add comments, fix sampling bug, add tdp0604 serial
    [adc_serve.py, main.c]
2025-07-02 Add multi trace viewer notebook
2025-07-02 Add elevated temperature data
2025-07-03 Fix bug leading to invalid cal measurements
    [main.c]
2025-07-08 Add soldering iron probe run
2025-07-08 Add wire probe batch
2025-07-09 Add anonymized gerber and PDF schematic exports
2025-07-09 Add new measurements of loop patches using both drivers
2025-07-09 Update all figures, include traces of calculated results
2025-07-11 Add short within trace interleaved batch
2025-07-14 Cut down a bunch of stuff, make space for majR measurements
2025-10-02 Add final camera ready export
2025-10-27 Add fabrication exports
    [bom.csv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]
2025-10-27 Add missing gerbers
2025-10-27 Repo re-org for artifact submission
    [74lvc_bent_1.csv, 74lvc_bent_3.csv, 74lvc_straight_1.csv, amp_out_span_2g.csv, amp_out_span_2g_rbw_10k_40kpt_0000.csv, board_out_span_2g_rbw_10k_40kpt.csv, bom.csv, max3748_bent_1.csv]
2025-10-27 README: Fix schematics path
2025-12-02 Add raw scope data
    [74lvc_fall_csv.csv, 74lvc_rise_csv.csv, SDS7404A_H12_CSV_C1_1.csv, max_fall_csv.csv, max_rise_csv.csv, pi3hdx_fall_74lvc_csv.csv, pi3hdx_fall_csv.csv, pi3hdx_mesh_short_pulse.csv]
2026-01-14 Update README with more board info
